lunhuisheng/40W-CCM-Boost-PFC/docs/README.md

# 40 W CCM Boost PFC 工程作品集索引

**2026-10-27 当前 RevB：**RevB 已由项目本人完成主要功能模块器件摆放与全板手工布线，并建立 PGND/AGND 底层分区覆铜。覆铜静态专项终审为 CONDITIONAL GO：可进入最终丝印整理与新版 Gerber/Excellon 本地 CAM 审查，尚未批准直接下单。 83 封装、557 走线、81 过孔、2 zone、0 未连接，KiCad DRC 0 Error、34 Warning；[详细报告](../../hardware/BoostPFC_40W_KiCad/revb_ground_final_review_2026-10-27/REVB_GROUND_POUR_FINAL_REVIEW.md)。本人手工完成 RevB 器件摆放和布线，工具辅助规则审查与文档。尚未下单、焊接或上电。

## 推荐分享顺序

1. [6 页求职快速展示版](output/pdf/40W_BoostPFC_求职快速展示版_最新版.pdf)：HR 或技术初筛。
2. [项目展示总报告](output/pdf/40W_BoostPFC_项目展示总报告_最新版.pdf)：完整概览和证据索引。
3. [项目计划书](output/pdf/40W_BoostPFC_项目计划书_最新版.pdf)、[电源设计](output/pdf/40W_BoostPFC_电源设计与实现报告_最新版.pdf)、[Simulink 验证](output/pdf/40W_BoostPFC_Simulink仿真与验证报告_最新版.pdf)、[PCB 工程](output/pdf/40W_BoostPFC_PCB设计审查与制造资料_最新版.pdf)、[面试手册](output/pdf/40W_BoostPFC_项目总结与技术面试手册_最新版.pdf)。

对应 Markdown：`00_项目展示总报告_最新版.md`、`01`～`05`、`06_求职快速展示版_最新版.md`。[原始证据清单](SOURCE_AUDIT.md)列出哈希与阶段边界。早期 PDF 保留作历史快照，**不得作为当前 RevB 状态**。图 18–30 来自最新 RevB 真实文件；仿真结果始终属于行为模型，不代表实测。

**下一阶段：**处置 DRC 警告、丝印和 `/RECT_IN` 旧悬空过孔，独立复核后生成新版制造文件并本地 CAM；正式下单需人工批准。
