lunhuisheng/40W-CCM-Boost-PFC/ATTRIBUTION.md

# 来源与贡献说明

早期学习与复现参考：[DeepooBelief/BoostPFC](https://github.com/DeepooBelief/BoostPFC)。该公开工程是第三方作品。本公开仓库不复制其原始工程文件，也不把第三方仿真或硬件测试结果称作自己的结果。

本仓库发布的是随后建立的 40 W CCM Boost PFC 自主设计作品：行为级 Simulink 模型与脚本、结构化仿真结果、KiCad 原理图和 RevB PCB、项目展示文档。原理图和 PCB 的器件摆放与 RevB 手工布线由项目作者完成；辅助脚本和工具参与了检查、数据整理和文档生成。

器件型号与数据表归其制造商所有。仓库没有收录第三方数据手册、Infineon 模型下载包、其他 LLC 开源仓库或原始 BoostPFC 仓库代码。
