lunhuisheng/40W-CCM-Boost-PFC/docs/05_项目总结_简历描述与面试手册.md

# 40 W CCM Boost PFC 项目总结、简历描述与面试手册

版本：2026-10-27，RevB 手工布线与覆铜专项终审。基于真实仿真结果、RevB 工程与[终审](../../hardware/BoostPFC_40W_KiCad/revb_ground_final_review_2026-10-27/REVB_GROUND_POUR_FINAL_REVIEW.md)；没有下单、焊接、上电或硬件性能实测。本人实际进行 RevB 器件摆放和全板手工布线；工具辅助建模、静态审查、文档与辅助验证。

## 1. 项目摘要与有证据的工作

本项目把 20–28 Vac/50 Hz 变换为 40 V/40 W，使用整流桥 + CCM Boost 功率级、平均电流模式双闭环、条件式预充旁路和软启动。自主行为级 Simulink 模型从空白模型创建，区别于仓库原开源示例；其 20/24/28 Vac 三点测试在模型内满足稳态误差 ±2%、纹波 ≤2 Vpp、PF ≥0.95、2～40 次 THD ≤10%。24 Vac/40 Ω 两个掉电相位在模型内满足 10 ms 后 ≥34 V。KiCad 项目有 RevA 历史修订、D1 三端错映射修复、独立 PCB 审查和**历史 RevA** 本地 CAM 制造包；RevB 已人工完成主要功能区摆件、557 条走线与 B.Cu PGND/AGND 分区覆铜；当前有 83 封装、81 过孔、2 zone、0 未连接，静态终审 CONDITIONAL GO。上述所有“通过”仅在各自证据层级成立。

最有工程价值的决策：

1. 保留失败启动基线，区分 4.5 A 电流参考上限与实际电流；通过“被动预充→带相位/压差/电流条件旁路→PWM/参考斜坡→稳定后接载”把模型 24 Vac 最终全程峰值记录为 2.835 A（最后的 1.6 s 输入范围测试），而非将早期 6.875 A 隐藏。[证据](../../simulation/simulink/BoostPFC_Design/results/final_input_range/24Vac_metrics.json)。
2. 识别 28 Vac 线峰仅约 1.794 V 模型升压余量和接载峰值 3.968 A，明确这是行为模型边界，不声称器件级已稳健。[证据](../../simulation/simulink/BoostPFC_Design/results/final_input_range/28Vac_metrics.json)。
3. 区分 40 W 恒功率和 40 Ω 恒电阻的掉电理论模型，并在零点/峰值两个相位从**输入实际归零**计时。[证据](../../simulation/simulink/BoostPFC_Design/results/hold_up_test/hold_up_summary.json)。
4. 用数据手册发现旧 PCB 的 D1 两个阳极分别接 VOUT/SW、形成器件内部短路风险；在独立工程中修正符号与封装映射，而不是仅修改 PCB 网络标签。[证据](../../hardware/BoostPFC_40W_KiCad/pcb_revA_2026-10-26_d1fix/D1_FIX_REPORT.md)。
5. 识别理想器件对照约 100.38% 的能量平衡异常，因此不把早期 92.82% 端口功率比值写成已验证效率。[证据](../../simulation/simulink/BoostPFC_Design/results/ideal_component_metrics.json)。

## 2. 可直接使用的简历描述

**项目：40 W CCM Boost PFC 电源设计与仿真｜个人学习项目，工具辅助工程实现** 规划 20–28 Vac/40 V·40 W 指标，建立整流 Boost、双 PI 电流/电压环及条件预充软启动的 Simulink 开关行为模型；完成三输入点、接载与掉电保持验证，记录 PF 0.9956–0.9971、2～40 次 THD 5.37%–6.29%、输出纹波 1.49–1.52 Vpp（均为**仿真**）；参与 KiCad 原理图与 RevA PCB 审查，发现并修正 D1 封装极性错映射，完成历史 RevA Gerber/钻孔本地 CAM 核验；本人完成 RevB 主功率、Gate、Kelvin/OCP、锁存、MCU 去耦与辅助供电模块器件摆放和全板手工布线，并配置 Net Class/线宽/间距，完成 PGND/AGND 分区覆铜静态终审；当前进行丝印与制造前审查，尚未下单或进行硬件性能实测。

若招聘方对个人贡献追问，可补充：本人负责设定规格、理解并审阅拓扑/控制/关键引脚及结果，使用 Codex、KiCad CLI 和 MATLAB 脚本辅助建模、检查、记录；不宣称所有模型与审查脚本均由本人手工独立敲写；RevB PCB 器件摆放与布线由本人手工完成。

## 3. 三分钟项目介绍稿

“我做的是一套 40 W、40 V 输出的低压交流输入 Boost PFC 学习项目，输入范围 20 到 28 Vac，额定 24 Vac，开关频率 50 kHz。这个项目的目标是完整走过规格、参数、控制、仿真、原理图和 PCB 审查流程，目前还没有制作或测试实物。

功率级由整流桥、470 微亨电感、MOSFET、Boost 二极管和 2200 微法输出电容构成。控制上用电压外环决定输入电流幅值，电流内环让电感电流参考跟随整流输入电压，再用 PWM 调制。启动阶段发现仅靠固定延时，预充旁路后电感电流仍会冲高；我保留了各失败版本，改成电压、输入相位相关的压差与电流共同合格后旁路，再做 100 毫秒参考斜坡，输出稳定才接 40 欧负载。

最终行为模型在 20、24、28 Vac 三点的输出平均值都接近 40 V，纹波约 1.49 到 1.52 Vpp，PF 约 0.996，2 到 40 次谐波算出的 THD 约 5.37% 到 6.29%。24 Vac 的 10 毫秒掉电保持在过零和峰值两个相位都达到 34 V 以上。不过 28 Vac 线峰的升压余量很小，而且这些全是软件模型结果。

硬件侧，我重点核对了四端分流器 Kelvin 连接、AGND/PGND 的单点连接、比较器直接关断与硬件故障锁存，还在 PCB 交叉审查中发现 D1 三端封装的阳极/阴极网络错接，修复后才进入历史 RevA 制造文件的本地 CAM 检查。目前我在 RevB 上完成主要功能区人工摆件和全板手工布线，专项补齐 STM32G431 多电源去耦，地铜经静态终审有条件通过。下一步是解决丝印和残余警告，再做新版制造文件的本地 CAM 审查。现在没有下单或硬件测试，因此我不会把仿真 PF、效率或保护阈值称为实测。”

## 4. 高频技术问答（12 题）

1. **为什么选 Boost PFC？** 输入电感便于塑造整流电流，输出可高于整流电压；但在 28 Vac 线峰接近 40 V 时，最小占空比和器件压降会限制调节能力，需单独核查。[设计报告](02_电源设计与实现报告.md)
2. **CCM 是不是全工频周期成立？** 不是。电流在主要传功区按连续模式设计，过零附近可能到零；行为模型不能证明所有工况严格 CCM。[设计记录](../../simulation/simulink/BoostPFC_Design/DESIGN_NOTES.md)
3. **为什么电流参考与整流电压成比例？** 电压环输出给出幅值，`iL,ref=A_v·vrect/Vrect,pk`，使交流输入电流包络近似同相正弦；若限幅、延迟或线峰余量不足，仍会有 THD。[初始化脚本](../../simulation/simulink/BoostPFC_Design/BoostPFC_Design_Init.m)
4. **为什么电压环慢于电流环？** 电流环约 3.04 kHz，电压环约 5.86–8.75 Hz 的连续平均分析具有带宽层级；慢电压环避免追逐 100 Hz 功率脉动。实际采样/PWM 延迟未确认。[环路 JSON](../../simulation/simulink/BoostPFC_Design/results/loop_audit/loop_audit_summary.json)
5. **470 µH 怎么确定？** 是项目初值，通过开关纹波和电流峰值行为仿真做了筛查；尚未完成磁芯损耗/温升/容差下的最优选型，不能说已全方面验证。[功率热审查](../../hardware/BoostPFC_40W_KiCad/prepcb_risk_review_2026-10-26/POWER_THERMAL_REVIEW.md)
6. **2200 µF 的依据？** 恒功率 40→34 V/10 ms 理论至少 1801.8 µF，100 Hz/2 Vpp 近似至少 1591.5 µF；模型零点/峰值掉电 10 ms 后为 35.568/35.704 V。实际电容容差、ESR、寿命仍待验证。[掉电 JSON](../../simulation/simulink/BoostPFC_Design/results/hold_up_test/hold_up_summary.json)
7. **4.5 A 算硬件限流吗？** 不算。一个 4.5 A 是模型的电流幅值参考上限，另一个是模型故障阈值；实际周期抑制设 4.0 A。硬件 R2/INA180/TLV3201/驱动器链只有静态与网络审查，动态峰值和关断延迟尚未实测。[风险审查](../../hardware/BoostPFC_40W_KiCad/prepcb_risk_review_2026-10-26/PREPCB_RISK_REVIEW.md)
8. **PWM 关了，为什么还会有浪涌？** 整流输入仍能经 L1 和 D1 被动充 C1，PWM 抑制不能控制这条通路；所以先设预充电阻、旁路时检查压差和电感电流。[启动记录](../../simulation/simulink/BoostPFC_Design/DESIGN_NOTES.md)
9. **四端分流器的 Kelvin 意义？** 功率端串接回流，两个采样端独立引到 INA180，避免大电流焊盘/走线压降混入 10 mΩ 测量；主回流不能绕过 R2。[PCB 审查](../../hardware/BoostPFC_40W_KiCad/independent_final_review_opus_2026-10-26/INDEPENDENT_FINAL_REVIEW_OPUS.md)
10. **D1 修过什么致命错误？** 该三端器件 1/2 为内部相连阳极、3 为阴极。旧 PCB 将 1 接 VOUT、2 接 SW，装件后可能短接两网；修订三端符号让 1/2=SW、3=VOUT，再从原理图正常同步 PCB。[修复报告](../../hardware/BoostPFC_40W_KiCad/pcb_revA_2026-10-26_d1fix/D1_FIX_REPORT.md)
11. **DRC=0、CAM 通过为何还不能说电源可用？** DRC 查规则，CAM 查制造数据的静态一致性，不覆盖器件内部引脚、热、瞬态保护和真实上电。该项目旧 DRC=0 仍被发现 D1 错映射。[阶段 PCB 报告](04_PCB设计审查与制造资料_阶段版.md)
12. **效率多少？** 尚无可信效率结论。早期非理想模型的端口比约 92.82%，但理想对照出现 100.38%，提示数值能量平衡问题；不能写成 92.82% 已验证，更没有实物效率。[原 JSON](../../simulation/simulink/BoostPFC_Design/results/ideal_component_metrics.json)

## 5. 可能的质疑与诚实回答

| 质疑 | 有证据的回答 |
|---|---|
| “这是开源项目改名吗？” | 根仓库确有开源工程；自主 `BoostPFC_Design` 模型另由建模脚本从空白建立。要展示脚本与独立结果，并明确学习来源。 |
| “40 W 为何连实物都没上电？” | 当前目标是设计与仿真作品，完成静态 KiCad/CAM；没有实验室条件，故所有物理性能保持未验证，裸板也尚未下单。 |
| “28 Vac 结果通过就没有风险？” | 模型稳态指标通过，但线峰升压余量约 1.794 V，接载峰值逼近行为级 4 A 设定；器件压降、死区、寄生和温度可能改变结论。 |
| “为什么接载会跌到 33.66 V？” | 20 Vac 最终行为测试确有该最低值，且没有正式负载瞬态下限；不能拿另一个掉电 34 V 指标判负载动态失败或成功。 |
| “为什么 PCB 报告哈希不匹配？” | 历史制造 ZIP 未变，但当前 d1fix/RevB 文件后来发生保存或编辑，原因未审定；重新制造必须用新哈希重做完整版本和 CAM 核查。 |

最终可用于展示的边界句：**“已完成自主 40 W Boost PFC 行为模型、参数与控制分析、KiCad 原理图及历史 RevA PCB/本地 CAM 审查；RevB 主要模块人工摆件与规则配置已进行；最终走线、覆铜、裸板打样及实物电气验证尚未完成。”**

## 6. 2026-10-27 求职状态更新

RevB 已由项目本人完成主要功能模块器件摆放与全板手工布线，并建立 PGND/AGND 底层分区覆铜。覆铜静态专项终审为 CONDITIONAL GO：可进入最终丝印整理与新版 Gerber/Excellon 本地 CAM 审查，尚未批准直接下单。 当前 PCB SHA-256 `2BB23CBACD7A38E5F8491438F23DFACB0250224D6A2BCA3105C27D4691244414`，83 封装、557 走线、81 过孔、2 zone，0 未连接。由本人手工布局和布线，工具辅助 KiCad 规则检查、几何审查与文档整理。可在面试中展示 [当前全板图](figures/18_RevB_current_full_routed.png)、[Kelvin 局部](figures/21_RevB_Kelvin_U3.png)、[地铜终审](../../hardware/BoostPFC_40W_KiCad/revb_ground_final_review_2026-10-27/REVB_GROUND_POUR_FINAL_REVIEW.md)和行为模型结果。不可说“已下单/已打板”或把 PF、THD、效率写成硬件实测。

若被问 DRC 0 Error 是否等于能上电：回答“不是。还有 34 条警告、机械和热设计审查、制造文件 CAM、厂家审核；动态过流、温升、EMI、效率和 PF/THD 都没有硬件实测。”
