lunhuisheng/40W-CCM-Boost-PFC/docs/06_求职快速展示版_最新版.md

# 40 W CCM Boost PFC 求职快速展示版｜6 页

## 第 1 页｜项目
20–28 Vac / 50 Hz → 40 V / 1 A / 40 W，50 kHz，CCM Boost PFC。自主行为级仿真、KiCad 原理图及保护链、RevB 人工器件摆放与手工布线。

## 第 2 页｜行为模型结果
20/24/28 Vac 的 Vout 平均 39.9829/39.9910/39.9920 V；PF 0.99714/0.99652/0.99558；THD 5.3722/5.4714/6.2925%（2–40 次）；纹波 1.5213/1.5035/1.4910 Vpp。24 Vac 掉电 10 ms 后输出 35.5683 V（近过零）/35.7036 V（近峰值）。**Simulation result：非实物数据。**

## 第 3 页｜硬件架构
整流/预充 → L1/Q1/D1/C1 Boost → 输出；R2 四端 Kelvin → INA180A2 → TLV3201 → 独立硬件锁存/驱动关断；STM32G431 双环控制与 C40–C48 电源去耦。

## 第 4 页｜当前 RevB PCB
83 封装、557 走线、81 过孔、2 个 B.Cu 分区地 zone、0 未连接。本人完成布局和布线；工具辅助静态审查。NT1 静态单点连接 PASS；覆铜审查 CONDITIONAL GO。

## 第 5 页｜工程问题
启动冲击、28 Vac 升压余量、D1 三端错映射、Kelvin 采样、PGND/AGND 单点地、STM32G431 多供电脚去耦与功率/Gate/模拟网络类配置。每项均保留设计边界和未实测风险。

## 第 6 页｜当前状态
RevB 手工布局布线与分区覆铜静态审查完成。**Silkscreen → DRC → Gerber/Excellon → CAM → 厂家审核 → 人工批准裸板下单**。目标 2026-10-28 继续制造前收敛；尚未下单或进行任何实物电气验证。
