lunhuisheng/40W-CCM-Boost-PFC/hardware/latest/BoostPFC_40W_模块导线学习图册.pdf

# 01 交流输入、整流与预充

# 先沿 J1 → BR1 → R1 → RECT_IN 阅读；K1 的触点旁路 R1。下方 R41、Q2、R51、D41 是继电器线圈驱动，长导线将线圈回路接回 K1。

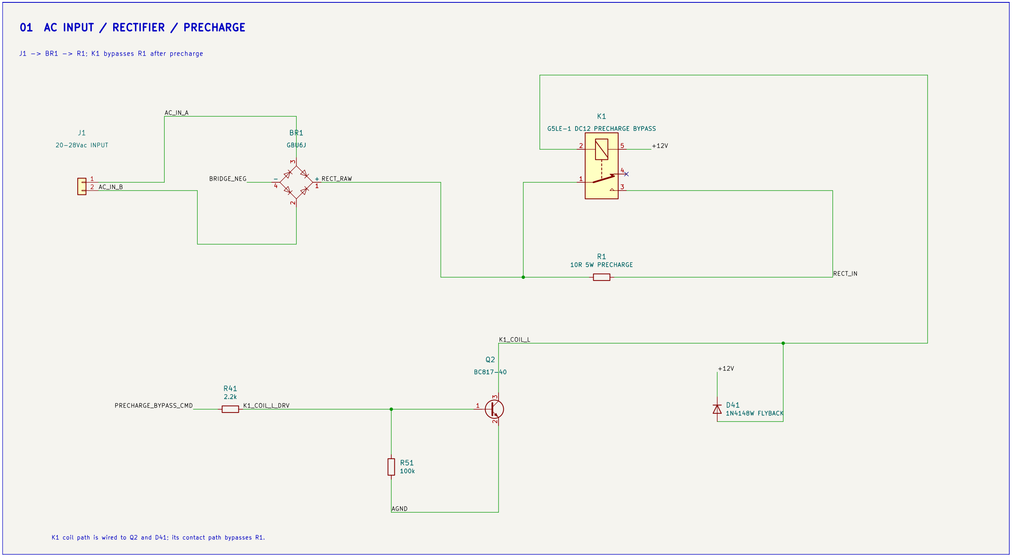
[picture p22: figure]
R1 10R 5W PRECHARGE; G5LE-1 DC12 PRECHARGE BYPASS; 1N4148W FLYBACK R51; GBU6J; 20-28Vac INPUT; AGND; RECT_IN +12V; BRIDGE_NEG; RECT_RAW; 01 AC INPUT / RECTIFIER / PRECHARGE; 10R 5W PRECHARGE; GBU6J +

K1_COIL_L PRECHARGE_BYPASS_CMD | K1_COIL_L_DRV

# J1 -> BR1 -> R1; K1 bypasses R1 after precharge

K1 coil path is wired to Q2 and D41; its contact path bypasses R1.

# 学习整理版：电气连接保持 RevB 基线；模块之间同名网络相连。

# 02 Boost 主功率级

沿 RECT_IN → L1 → SW → D1 → C1/J2 阅读。Q1 从 SW 接到 PGND；R2 功率端串在 PGND 与 BRIDGE_NEG 之间，两个 Kelvin

# 端单独引到模块 04。

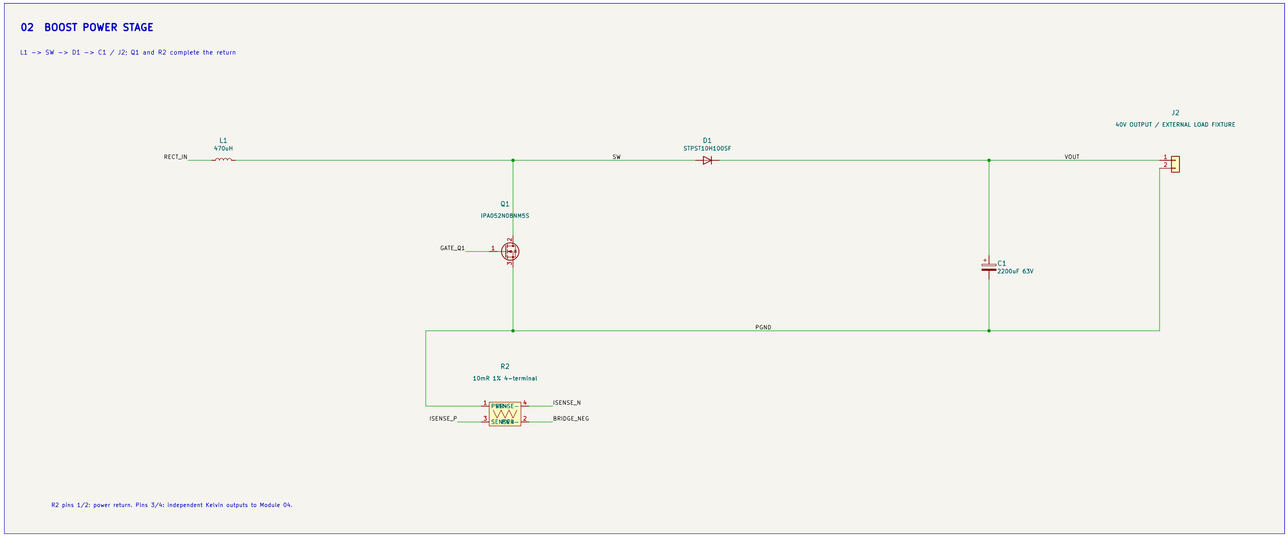
[picture p23: figure]
D1 STPST10H100SF 1; IPA052N08NM5S; PWR+; PWR-; SENSE+; SENSE-; 10mR 1% 4-terminal; 40V OUTPUT / EXTERNAL LOAD FIXTURE C1; VOUT; GATE_Q1; ISENSE_P; BRIDGE_NEG; ISENSE_N; PGND; RECT_IN; 10R 5W PRECHARGE; 10mR 1% 4-terminal PWR+; 2 3 D1 STPST10H100SF; 40V OUTPUT / EXTERNAL LOAD FIXTURE 1

## L1 -> SW -> D1 -> C1 / J2; Q1 and R2 complete the return 02 BOOST POWER STAGE

R2 pins 1/2: power return. Pins 3/4: independent Kelvin outputs to Module 04.

# 03 MOSFET 栅极驱动

沿 PWM_CMD → R30 → U2 → R31 → GATE_Q1 阅读。R33 是 PWM 下拉，R32/D3 接在 Gate 与 PGND 之间；DRIVER_DISABLE

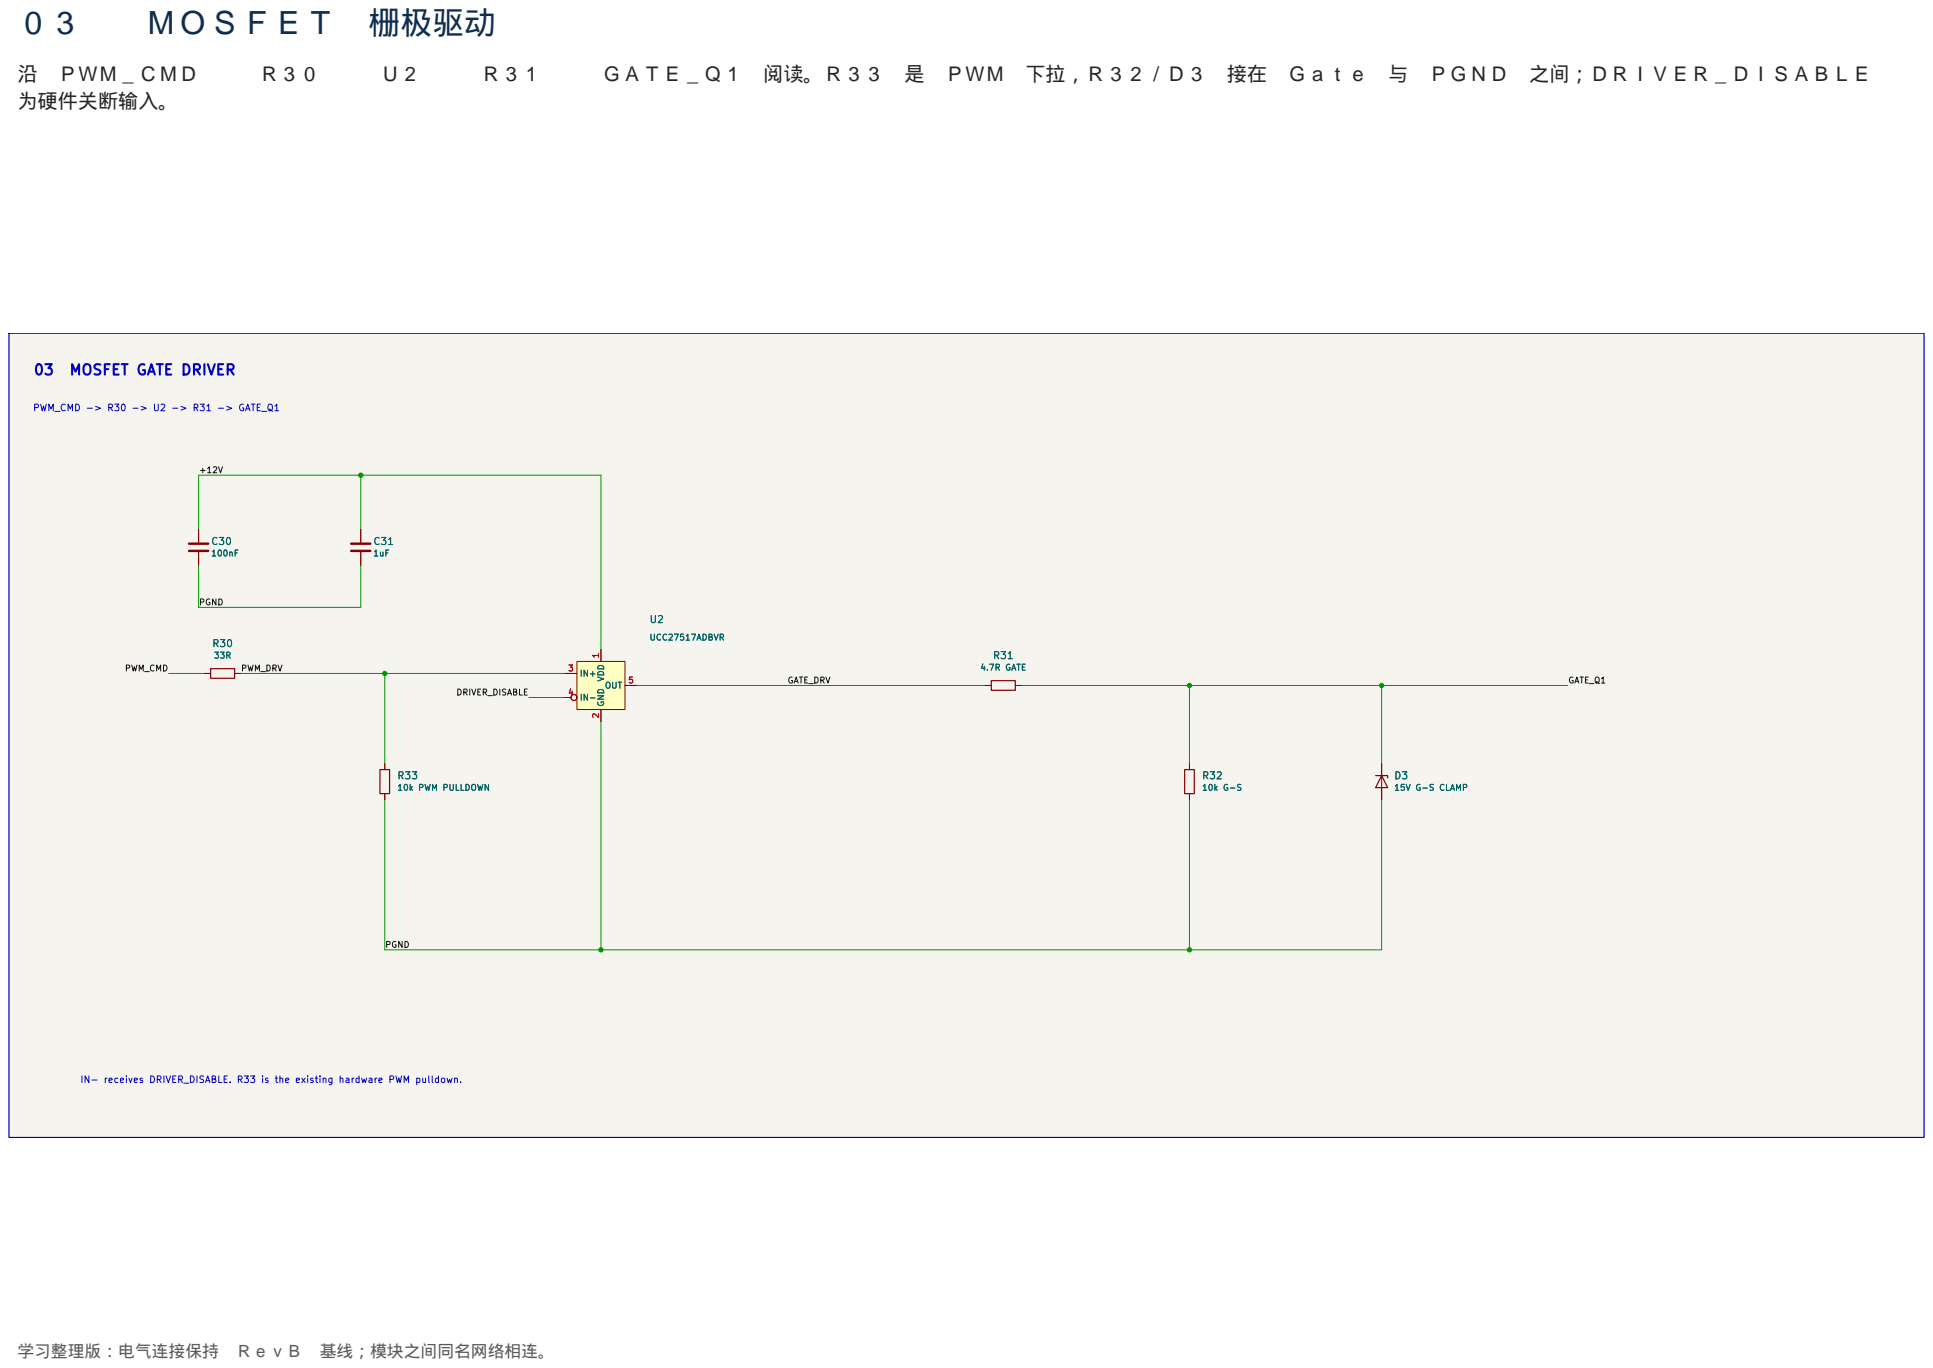
[picture p24: page 3]

IN- receives DRIVER_DISABLE. R33 is the existing hardware PWM pulldown.

# 04 Kelvin 电流采样

# ISENSE_P/N 分别经 R20/R21 接至 U3 两个输入；C20 跨接 INA_P 与 INA_N。U3 的输出 ISENSE_ADC 同时送给 MCU 和硬件比较器。

1 GND 2 +

3 -
4 V+

5 U3

# INA180A2IDBVR

C24

# 100nF U3 LOCAL

C20
1nF

R20
10R R21

10R

# AGND

# ISENSE_N

# ISENSE_P

# INA_P

# INA_N

# ISENSE_ADC +3V3

# AGND

# 04 KELVIN CURRENT SENSE

# R2 sense terminals -> R20 / R21 -> U3 -> ISENSE_ADC

C20 is between INA_P and INA_N, not an input-to-ground capacitor.

C20

1nF | C24

# 100nF U3 LOCAL U3

# INA180A2IDBVR

1 GND 2 +

3 -
4 V+

5

R20
10R R21

10R

# 05 输出与整流输入电压采样

# 左侧 R10/R11/R12 与 C10 测 VOUT；右侧 R13/R14/R15 与 C11 测 RECT_RAW。先看分压链，再看 ADC 节点和地回路。

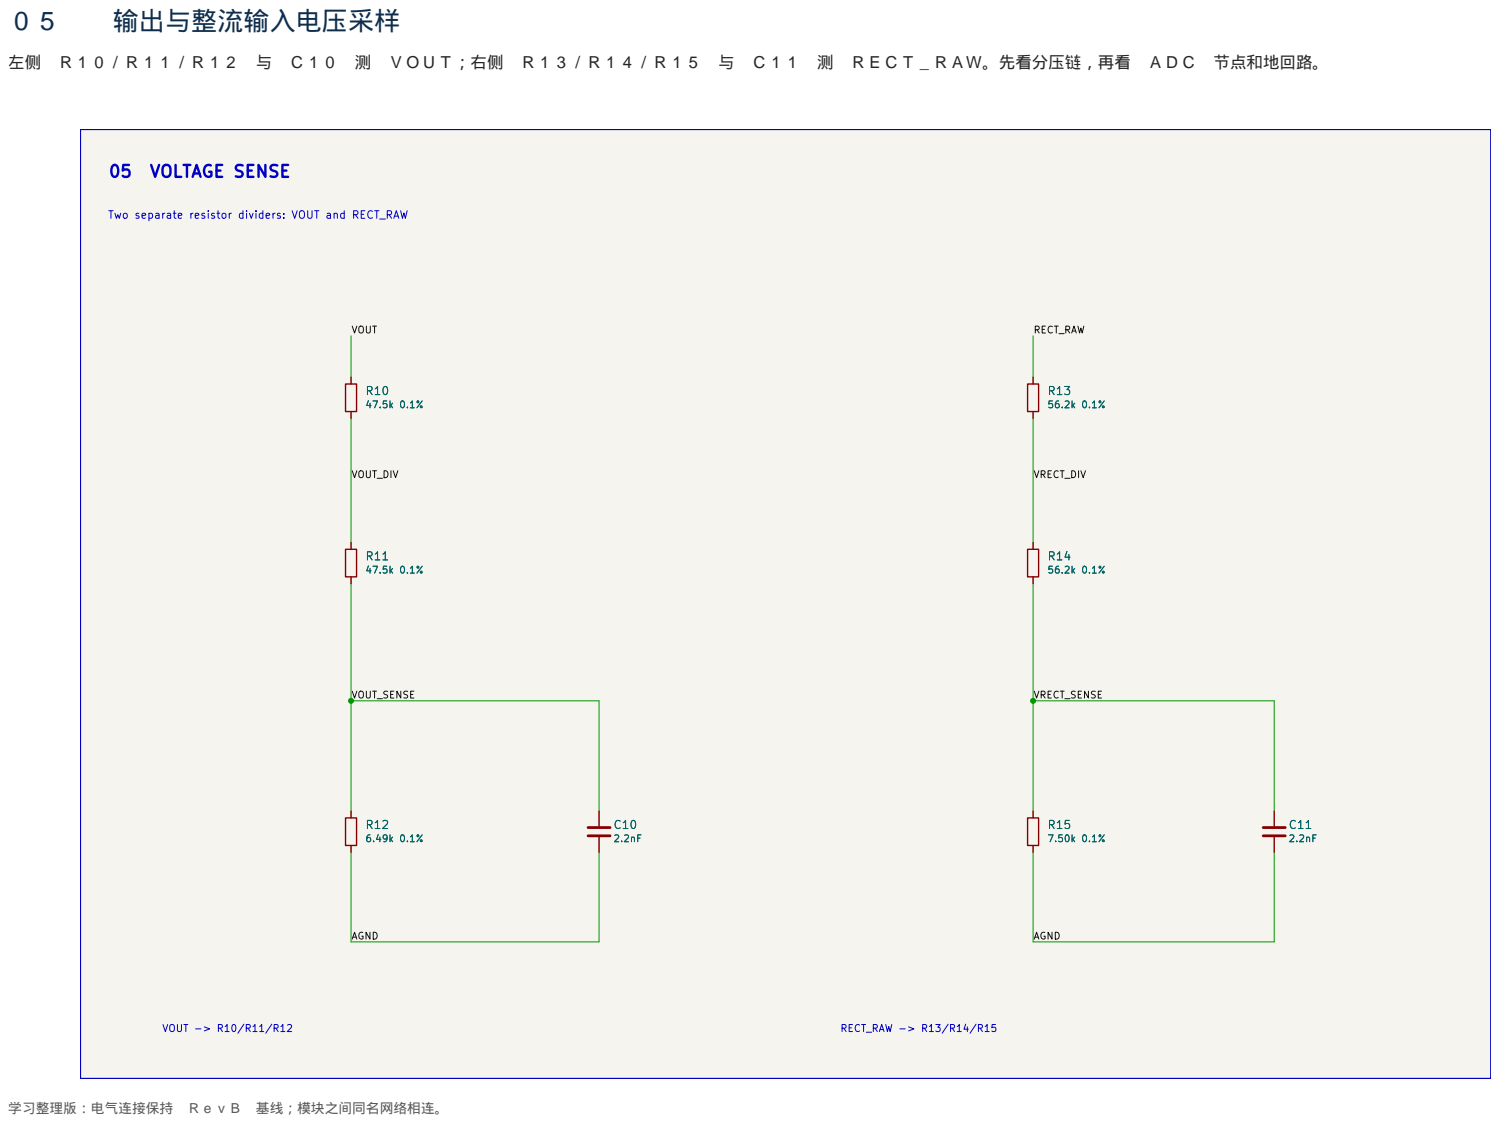
[picture p25: page 5]

Two separate resistor dividers: VOUT and RECT_RAW

# 06 硬件过流比较器

# R23/R24 生成 OCP_REF，C23 对参考节点去耦；U4 比较 ISENSE_ADC 与 OCP_REF，输出 OC_RAW。此页仅展示原有连接，不新增保护精度结论。

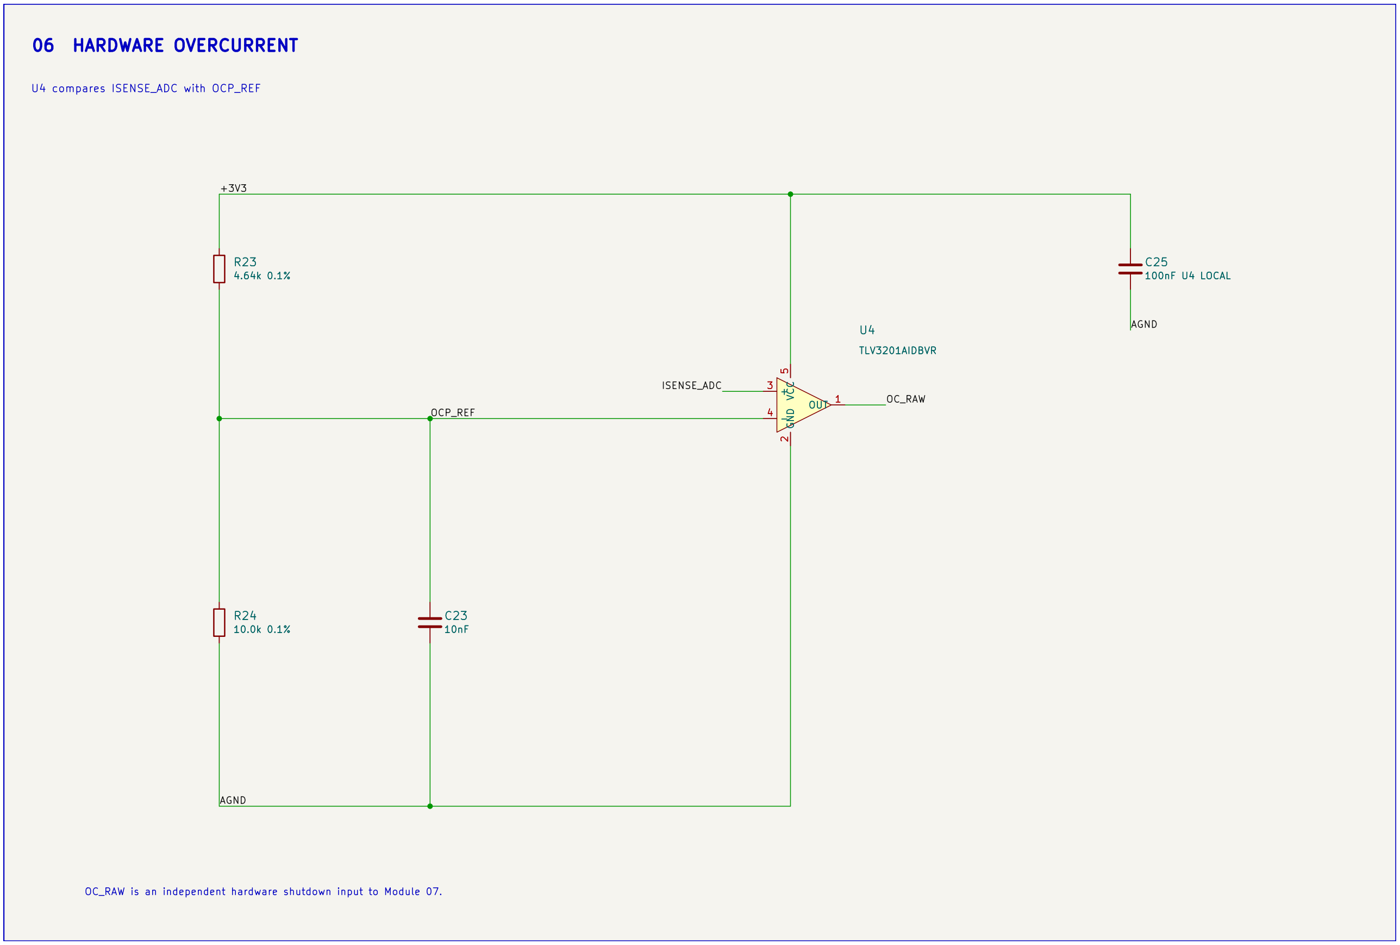
[picture p26: figure]
C25 100nF U4 LOCAL R24; OUT 1 GND; 3 - 4 VCC; TLV3201AIDBVR C23; AGND; ISENSE_ADC; OC_RAW; U4 compares ISENSE_ADC with OCP_REF; 06 HARDWARE OVERCURRENT; 100nF U4 LOCAL R23 4.64k 0.1% R24; TLV3201AIDBVR OUT 1 GND

VRECT_DIV | OCP_REF +3V3

OC_RAW is an independent hardware shutdown input to Module 07.

# 07 故障锁存、上电复位与人工复位

# 上方 U8 → U6 的 PRE 路径体现 POR；U6 的 Q 输出进入 U7。下方 SW1 → C65/R63/R62/D65 → U10 → U9 → U6 CLR

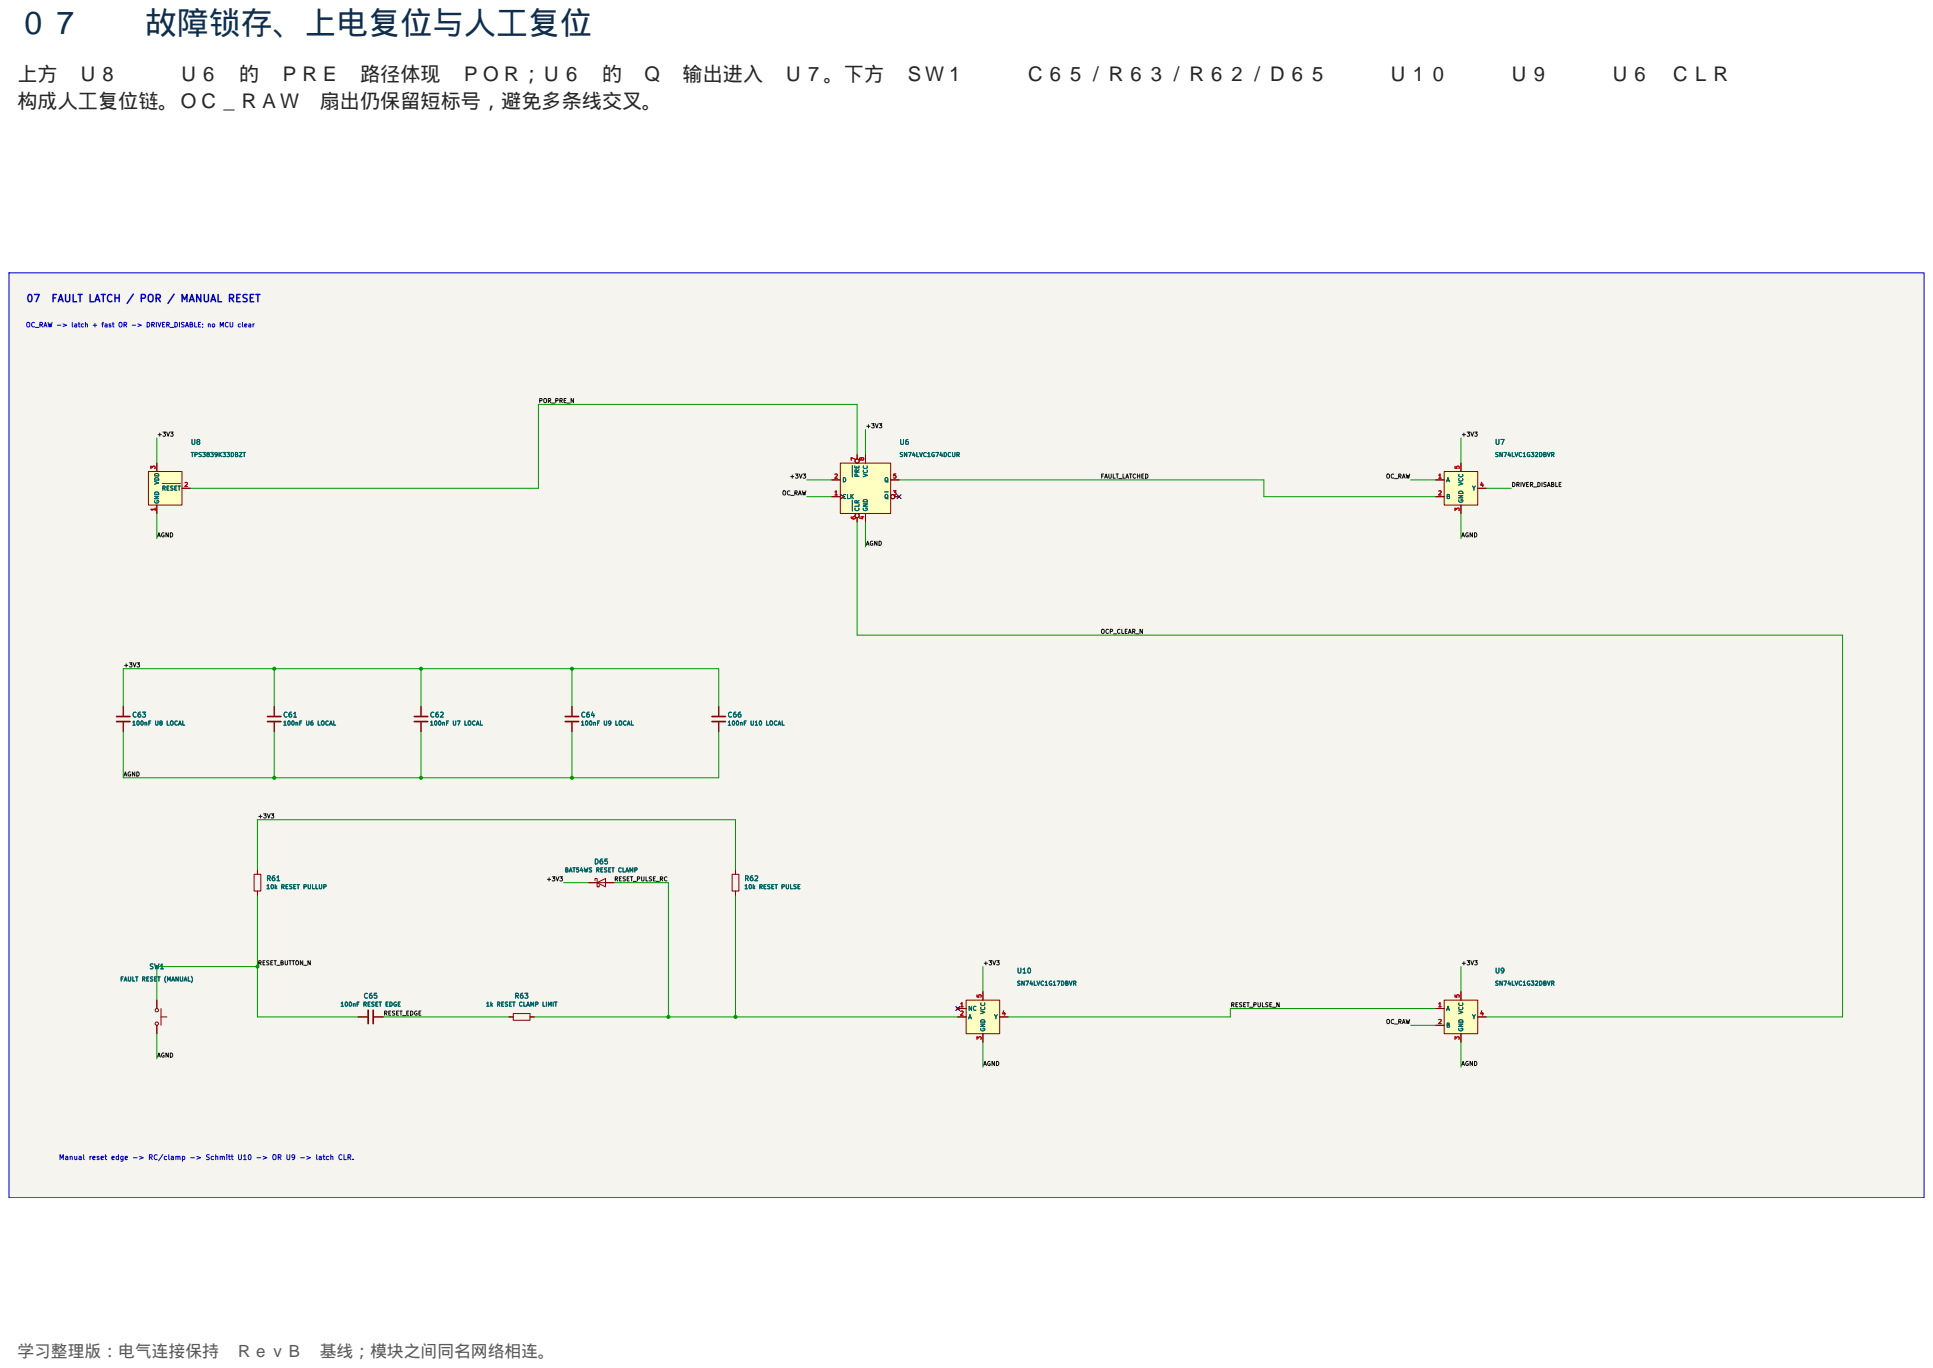
[picture p27: page 7]

07 FAULT LATCH / POR / MANUAL RESET

OC_RAW -> latch + fast OR -> DRIVER_DISABLE; no MCU clear

Manual reset edge -> RC/clamp -> Schmitt U10 -> OR U9 -> latch CLR.

# 08 STM32 控制接口与电源去耦

先看 U1 的供电、模拟采样、PWM、故障状态和 SWD 接口，再读 C40–C48。图上的去耦电容排成学习用电源母线，不代表 PCB 上应集中摆放；PCB 应各自靠近对应电源脚。

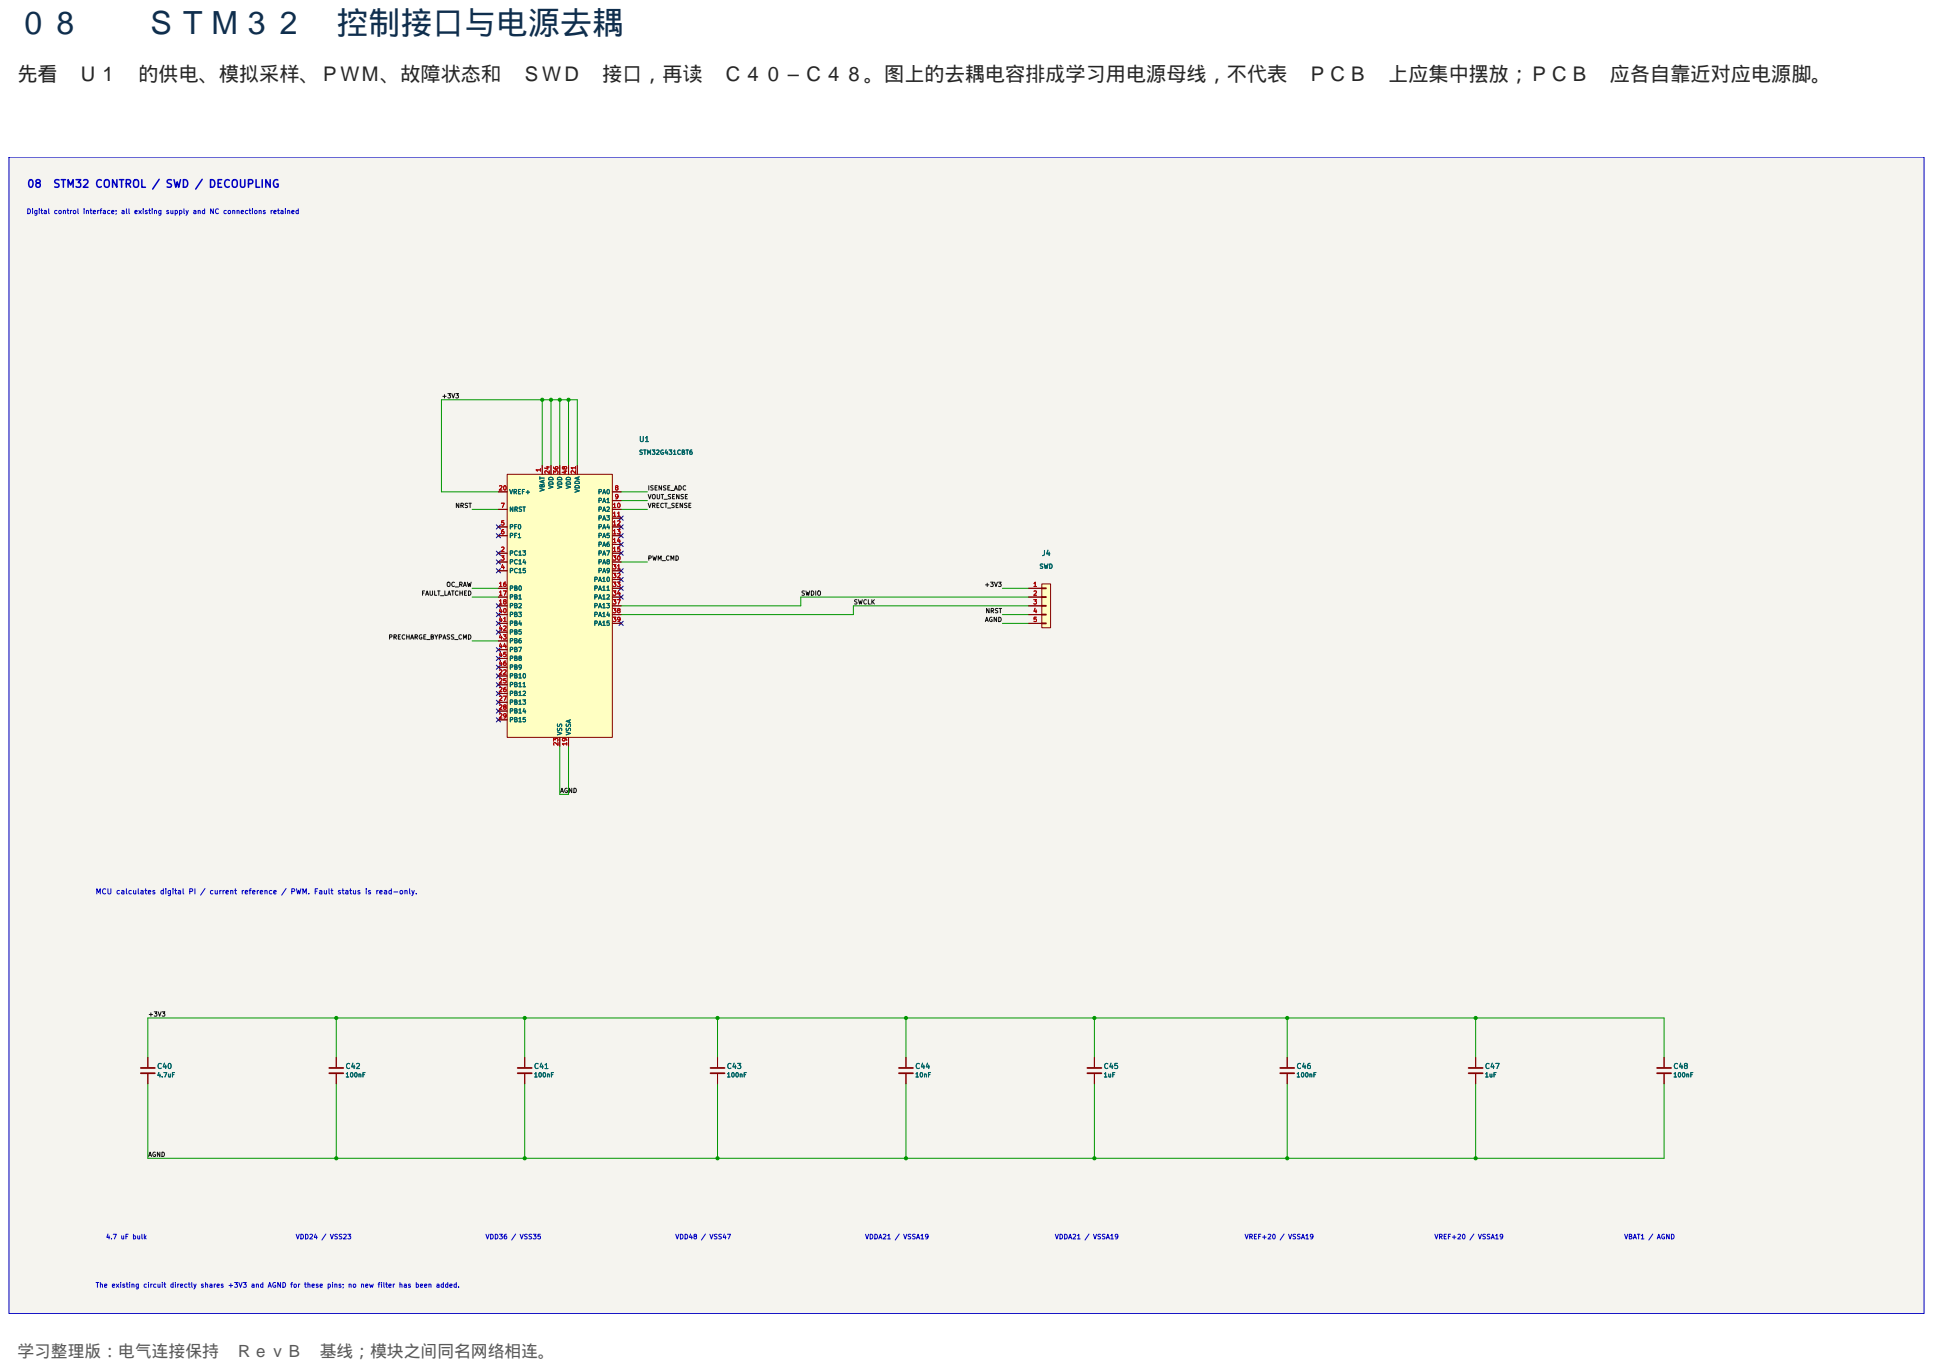
[picture p28: page 8]

Digital control interface; all existing supply and NC connections retained

# 09 12 V 辅助电源与 3.3 V 稳压

# 沿 J3 → U5 → +3V3 阅读。U5 的 IN/EN 均接现有 +12V；C50/C51 分别位于输入与输出，返回 AGND。

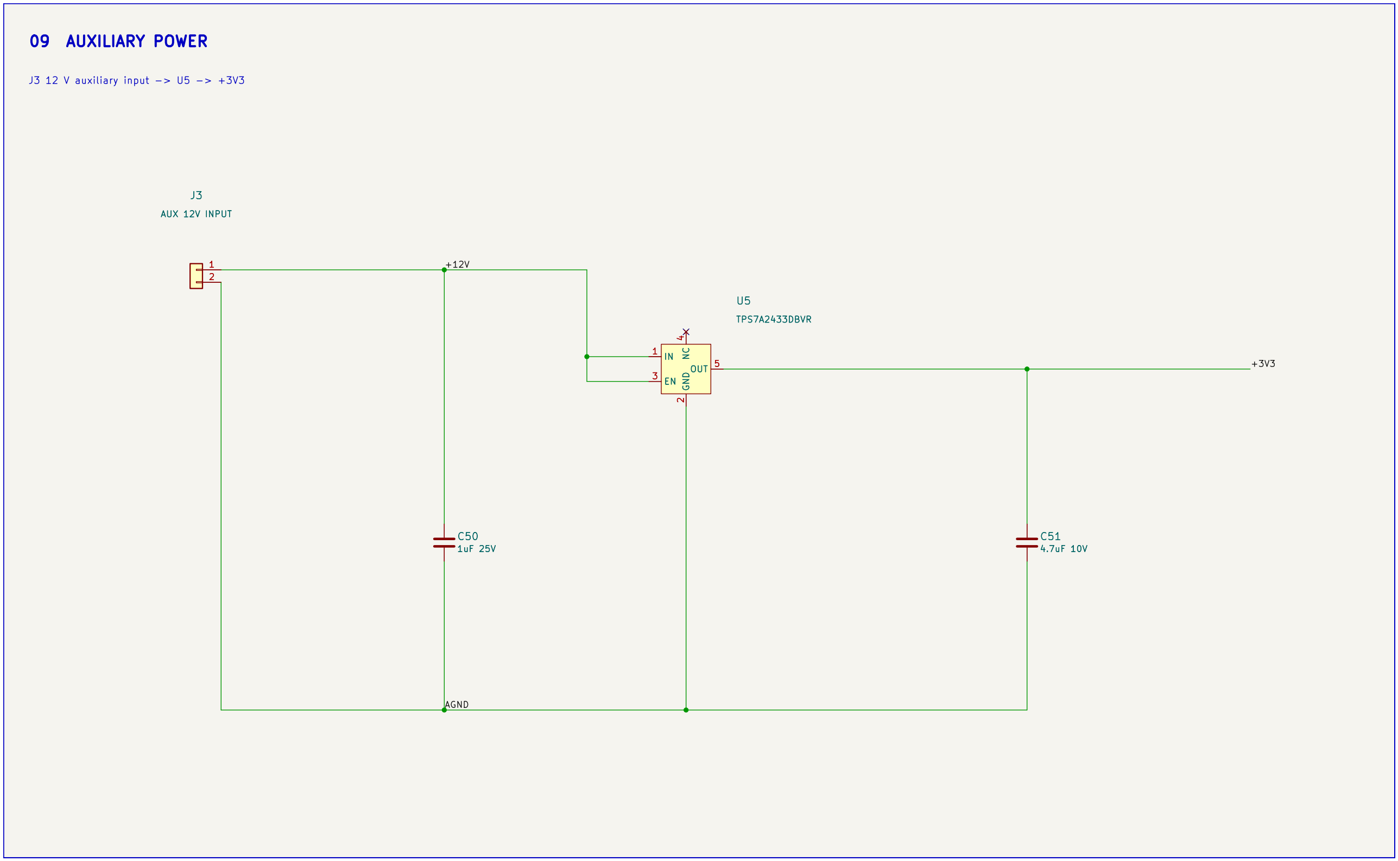
[picture p29: figure]
AUX 12V INPUT; GND; 4 OUT 5 U5; TPS7A2433DBVR; AGND; J3 12 V auxiliary input -> U5 -> +3V3; 09 AUXILIARY POWER; AUX 12V INPUT 1; 4 OUT 5

# 10 地单点连接与测试点

# NT1 的两端仍分别为 PGND 与 AGND。TP1–TP7 通过相同网络名对应前面各模块的测量节点；它们是观测接口，不是信号链中的串联元件。

O

P

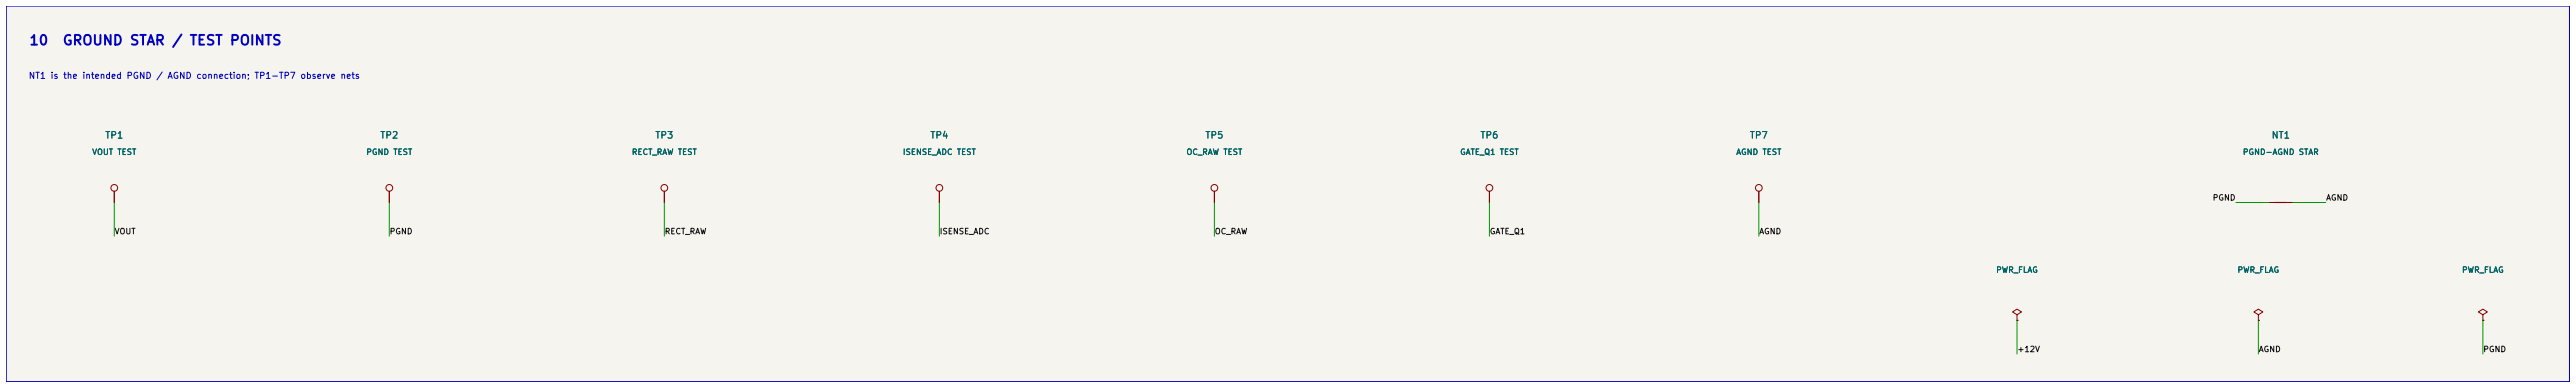
[picture p30: figure]
TP4 ISENSE_ADC TEST TP1; VOUT TEST; PGND TEST; OC_RAW TEST; PWR_FLAG; RECT_RAW TEST; AGND TEST TP6; GATE_Q1 TEST; PWR_FLAG NT1; PGND-AGND STAR; VOUT; PGND; ISENSE_ADC; OC_RAW; AGND; RECT_RAW; GATE_Q1; 10 GROUND STAR / TEST POINTS; ISENSE_ADC TEST

NT1 is the intended PGND / AGND connection; TP1-TP7 observe nets
