lunhuisheng/40W-CCM-Boost-PFC/docs/figures/29_RevB_current_schematic.png

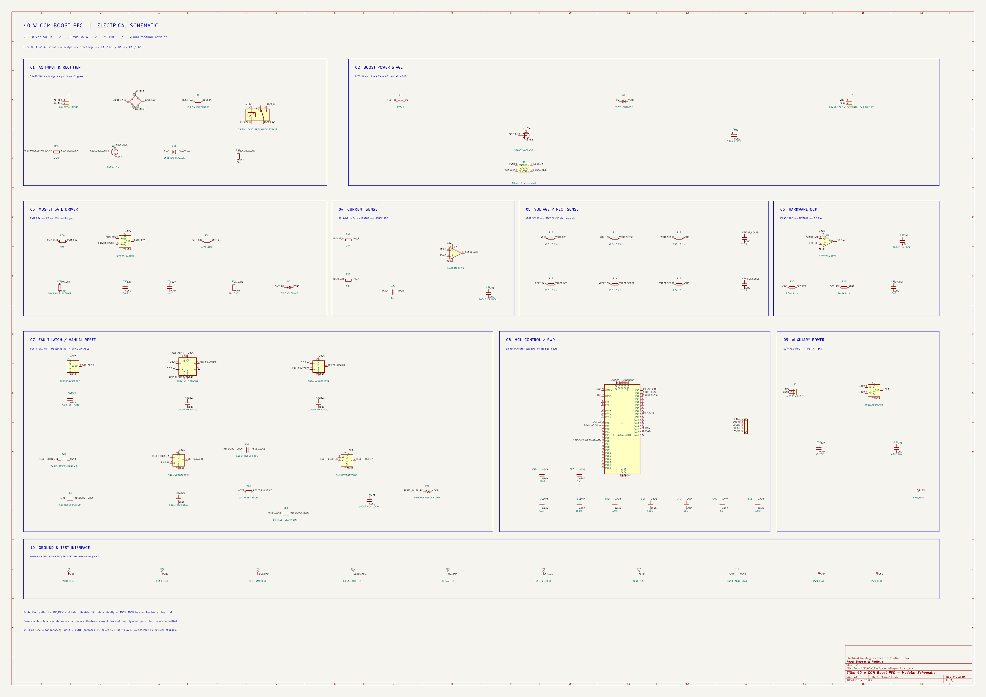
docs/figures/29_RevB_current_schematic.png
