lunhuisheng/40W-CCM-Boost-PFC/hardware/learning/previews/Module_02.png

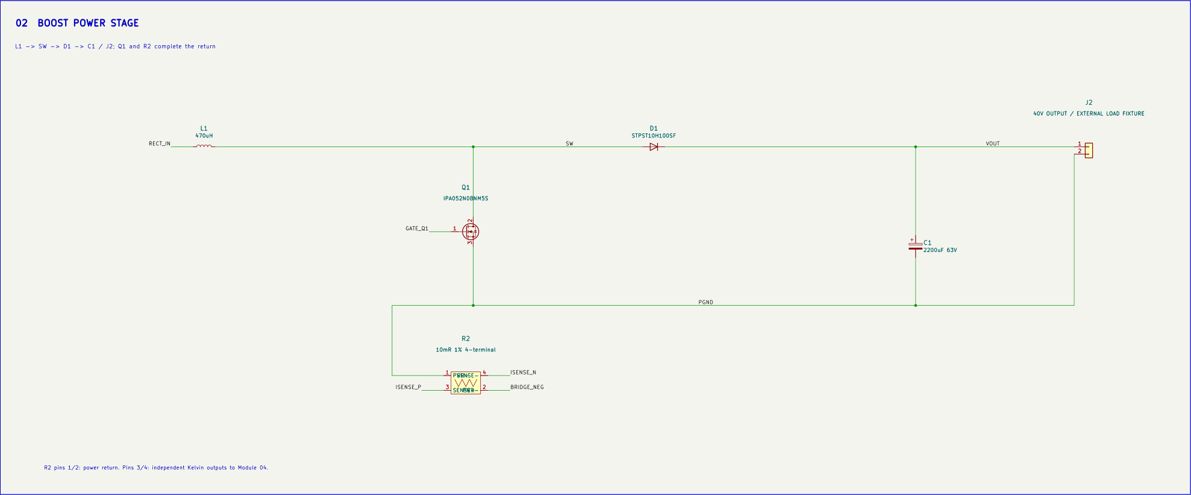
hardware/learning/previews/Module_02.png
