lunhuisheng/40W-CCM-Boost-PFC/hardware/learning/previews/Module_03.png

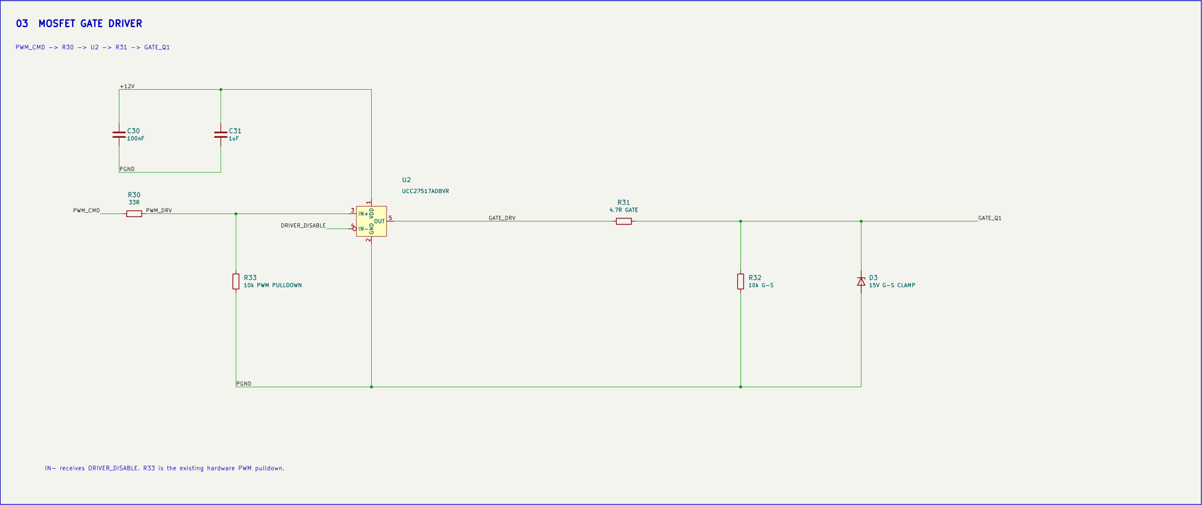
hardware/learning/previews/Module_03.png
