lunhuisheng/40W-CCM-Boost-PFC/hardware/learning/previews/Module_04.png

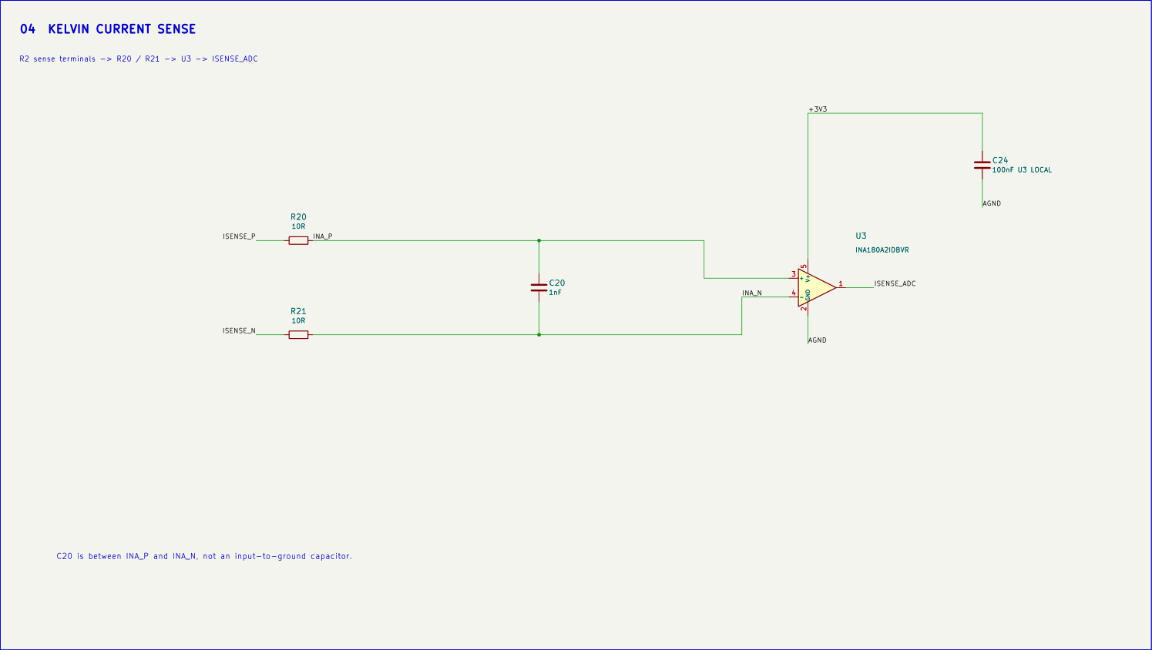
hardware/learning/previews/Module_04.png
