lunhuisheng/40W-CCM-Boost-PFC/hardware/learning/previews/Module_05.png

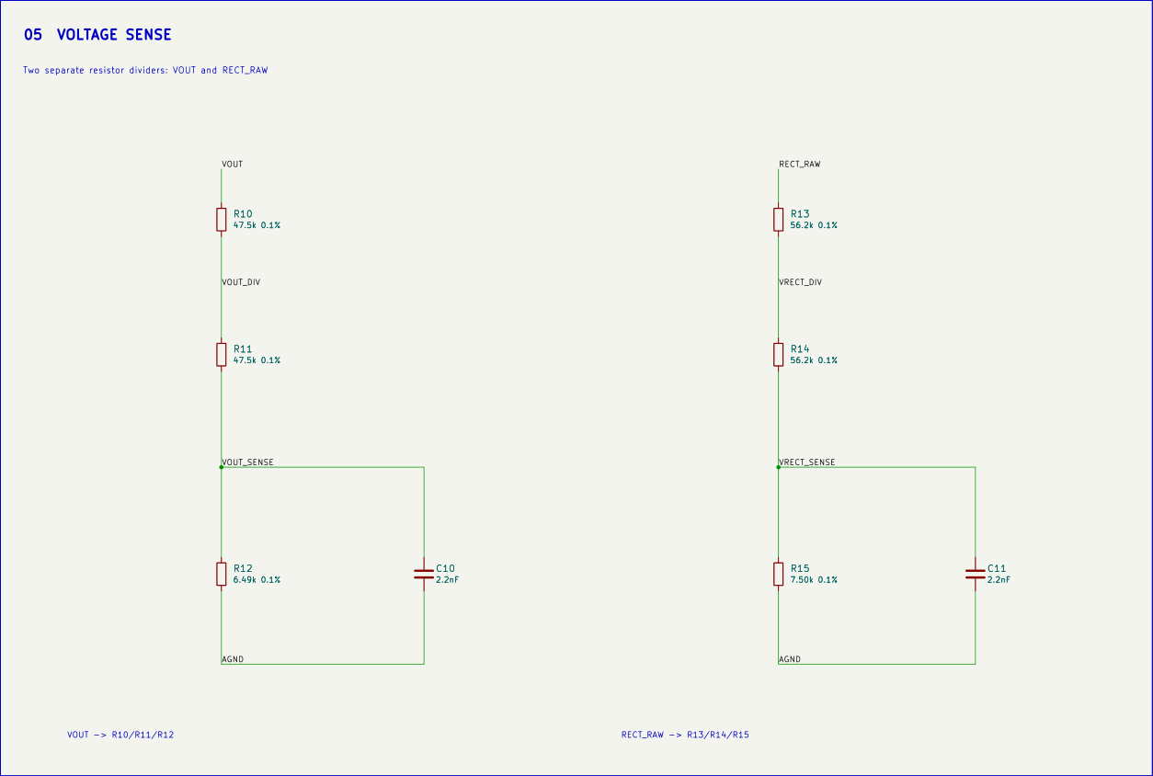
hardware/learning/previews/Module_05.png
