lunhuisheng/40W-CCM-Boost-PFC/hardware/learning/previews/Module_07.png

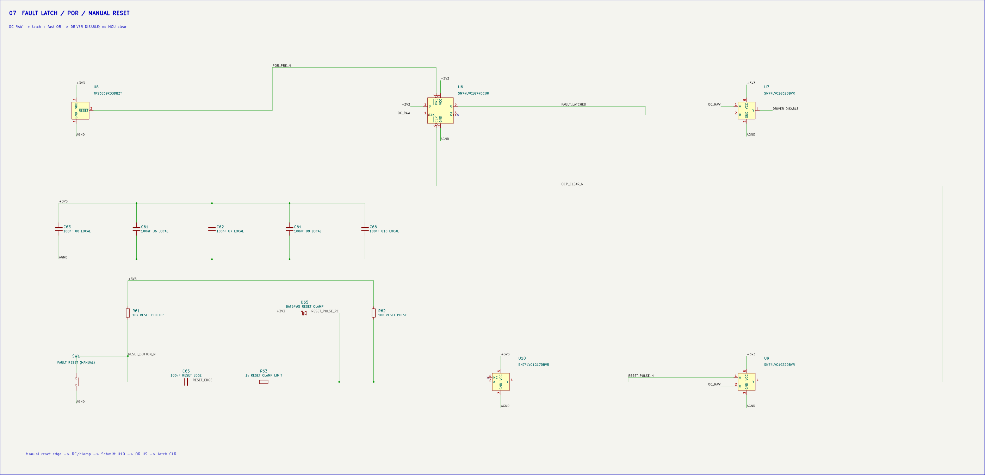
hardware/learning/previews/Module_07.png
