lunhuisheng/40W-CCM-Boost-PFC/hardware/learning/previews/Module_08.png

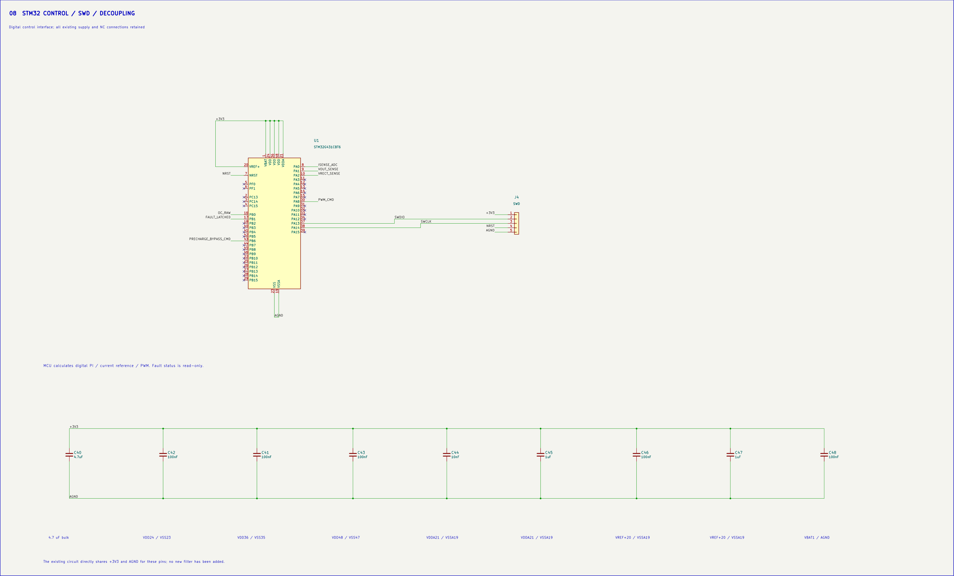
hardware/learning/previews/Module_08.png
