lunhuisheng/40W-CCM-Boost-PFC/hardware/learning/previews/Module_09.png

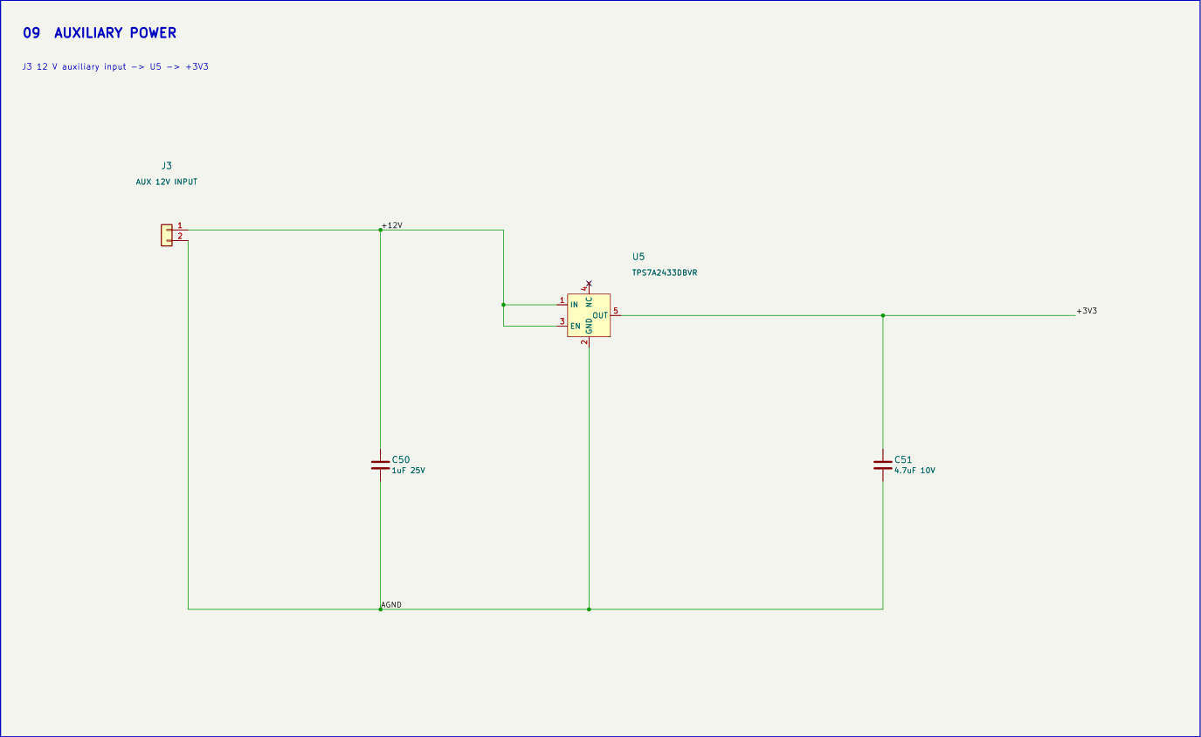
hardware/learning/previews/Module_09.png
