lunhuisheng/40W-CCM-Boost-PFC/hardware/learning/previews/Module_10.png

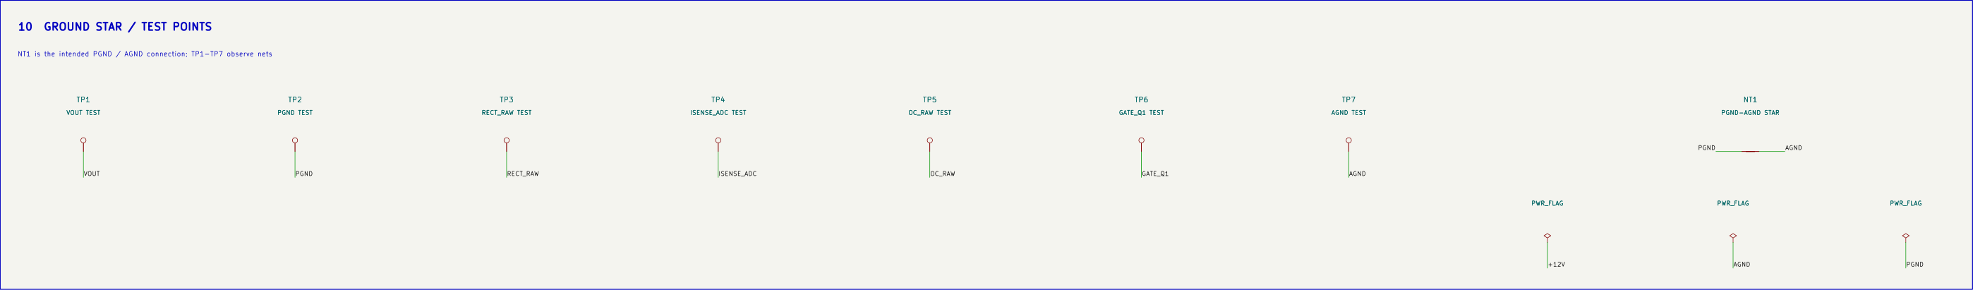
hardware/learning/previews/Module_10.png
