lunhuisheng/40W-CCM-Boost-PFC/simulation/BoostPFC_Design/results/load_step_responses.png

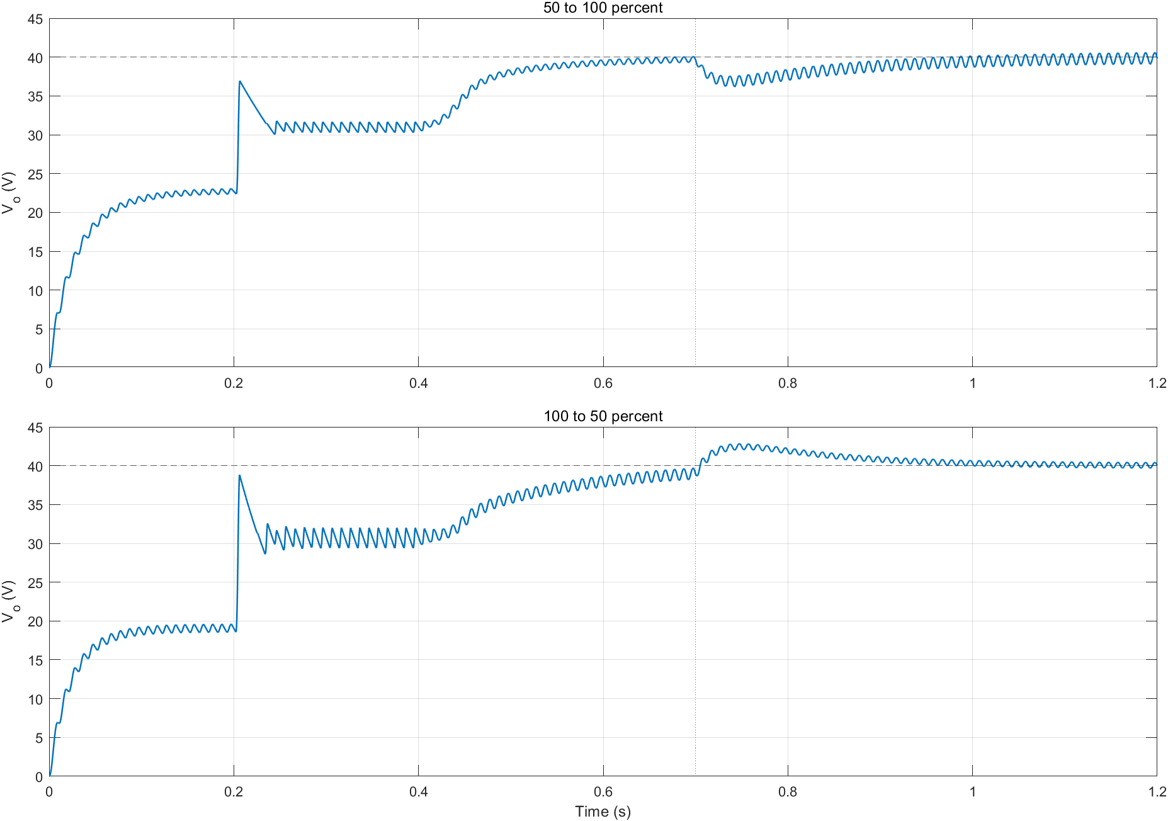
simulation/BoostPFC_Design/results/load_step_responses.png
