lunhuisheng/40W-CCM-Boost-PFC/simulation/BoostPFC_Design/results/controlled_startup/all_startup_strategy_comparison.png

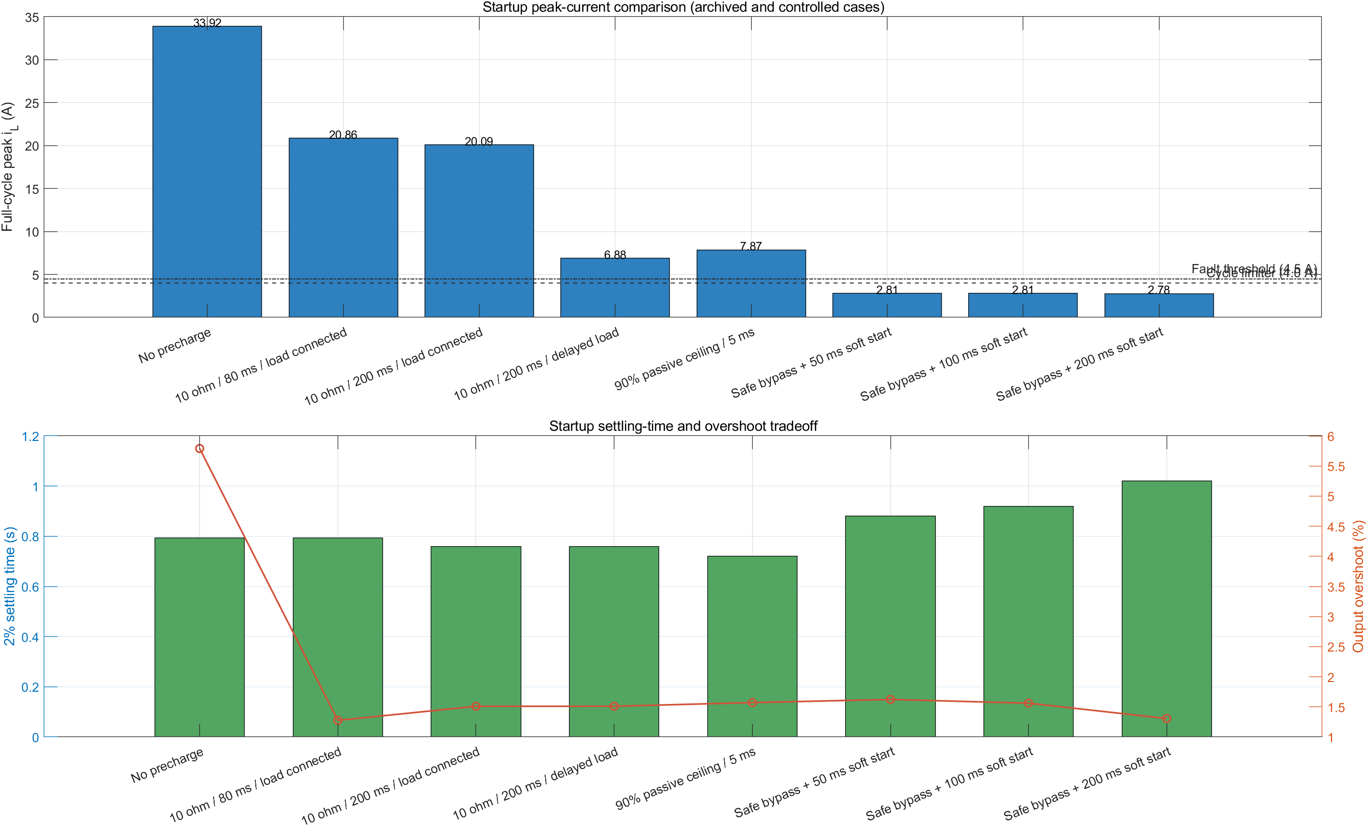
simulation/BoostPFC_Design/results/controlled_startup/all_startup_strategy_comparison.png
