lunhuisheng/40W-CCM-Boost-PFC/simulation/BoostPFC_Design/results/controlled_startup/controlled_startup_comparison.png

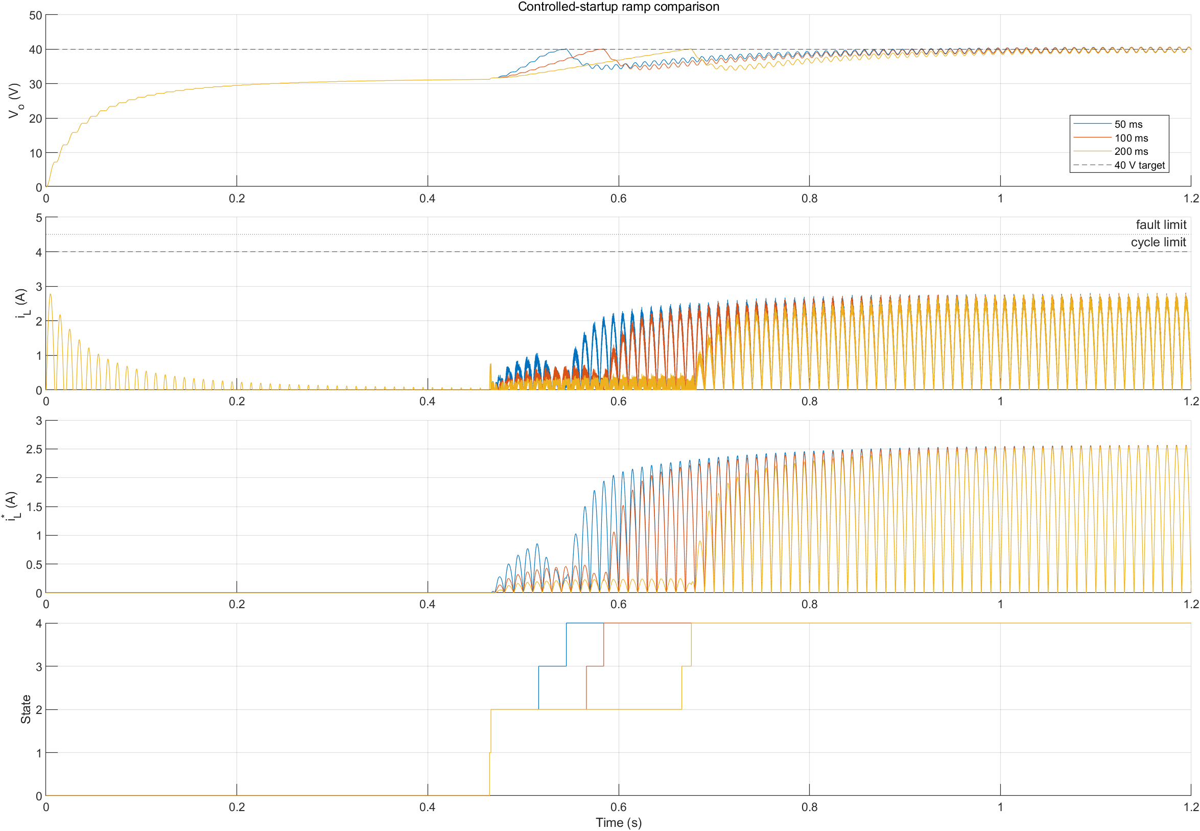
simulation/BoostPFC_Design/results/controlled_startup/controlled_startup_comparison.png
