lunhuisheng/40W-CCM-Boost-PFC/simulation/BoostPFC_Design/results/controlled_startup/protection_diagnostic.png

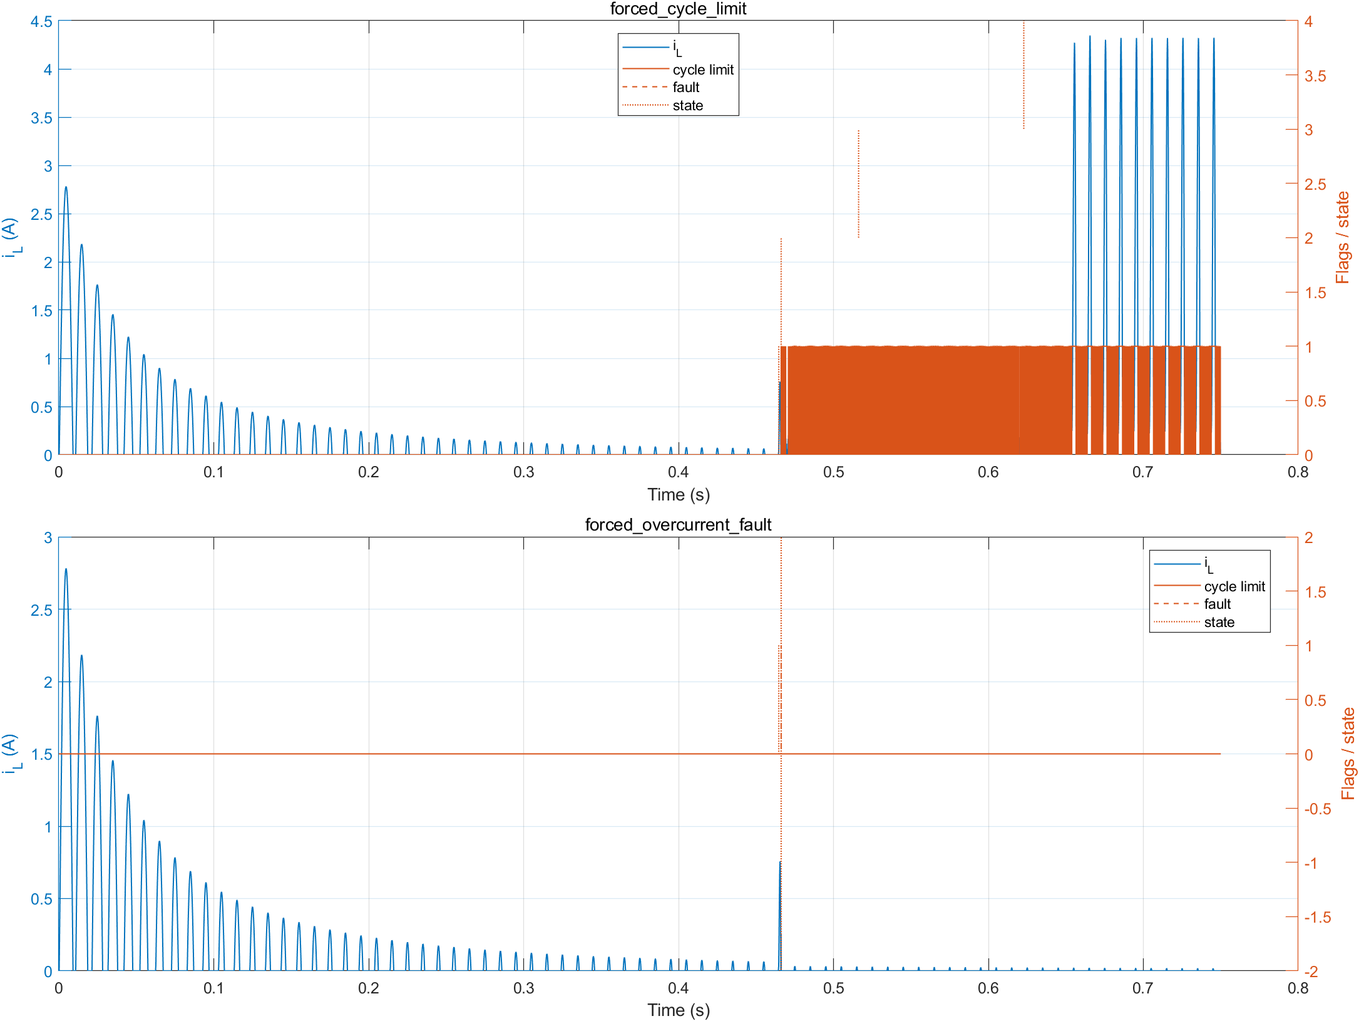
simulation/BoostPFC_Design/results/controlled_startup/protection_diagnostic.png
