lunhuisheng/40W-CCM-Boost-PFC/simulation/BoostPFC_Design/results/controlled_startup/ramp_050ms_waveforms.png

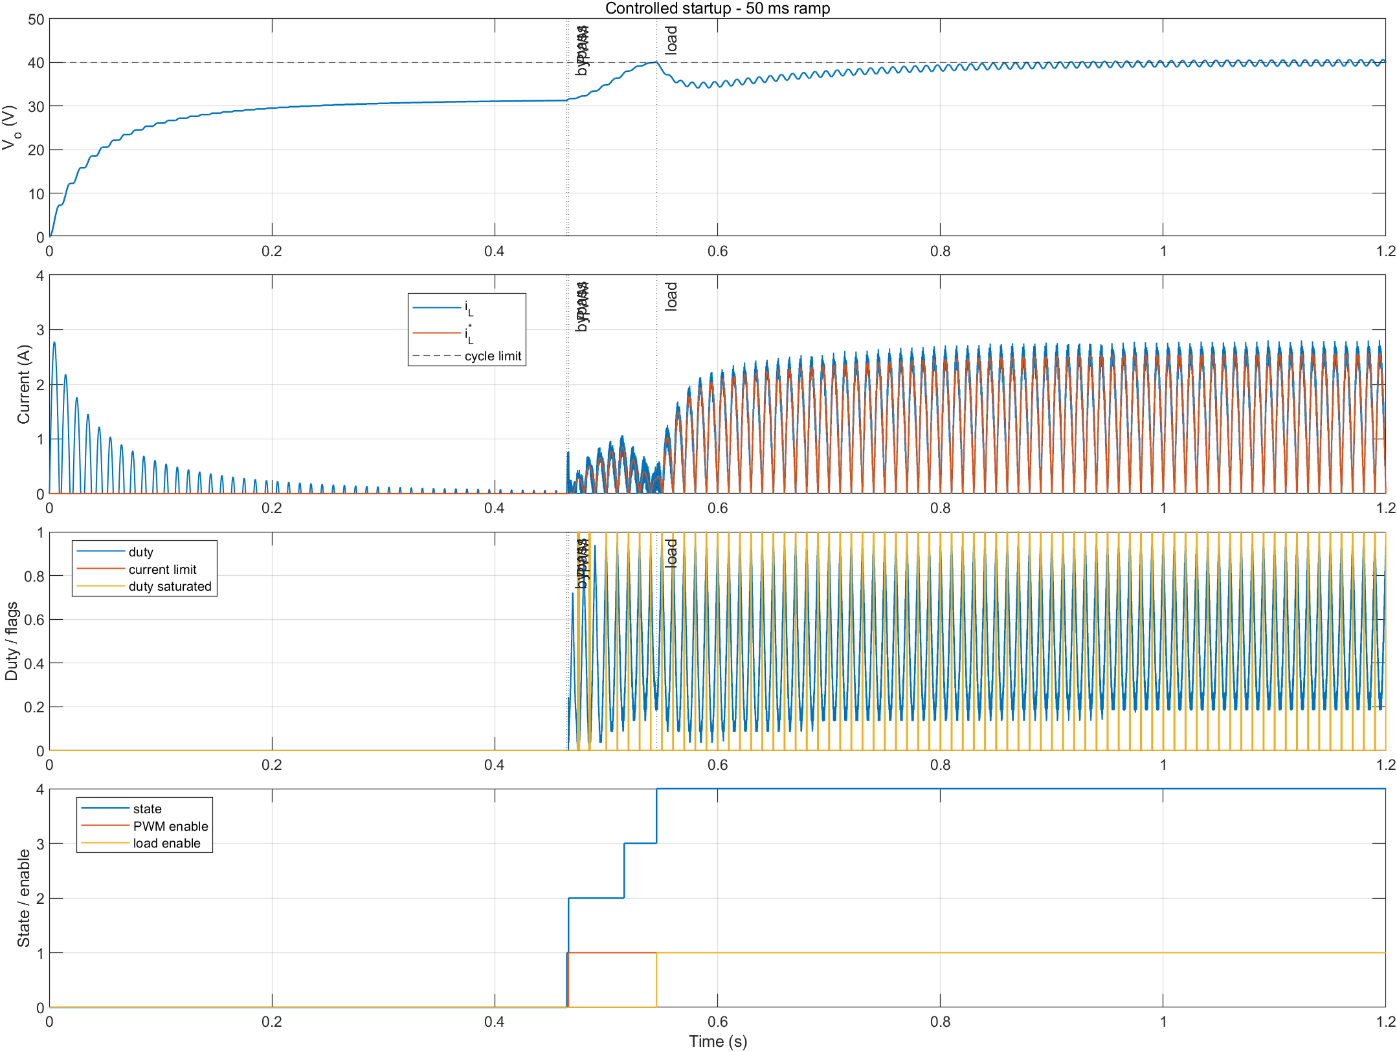
simulation/BoostPFC_Design/results/controlled_startup/ramp_050ms_waveforms.png
