lunhuisheng/40W-CCM-Boost-PFC/simulation/BoostPFC_Design/results/controlled_startup/ramp_200ms_waveforms.png

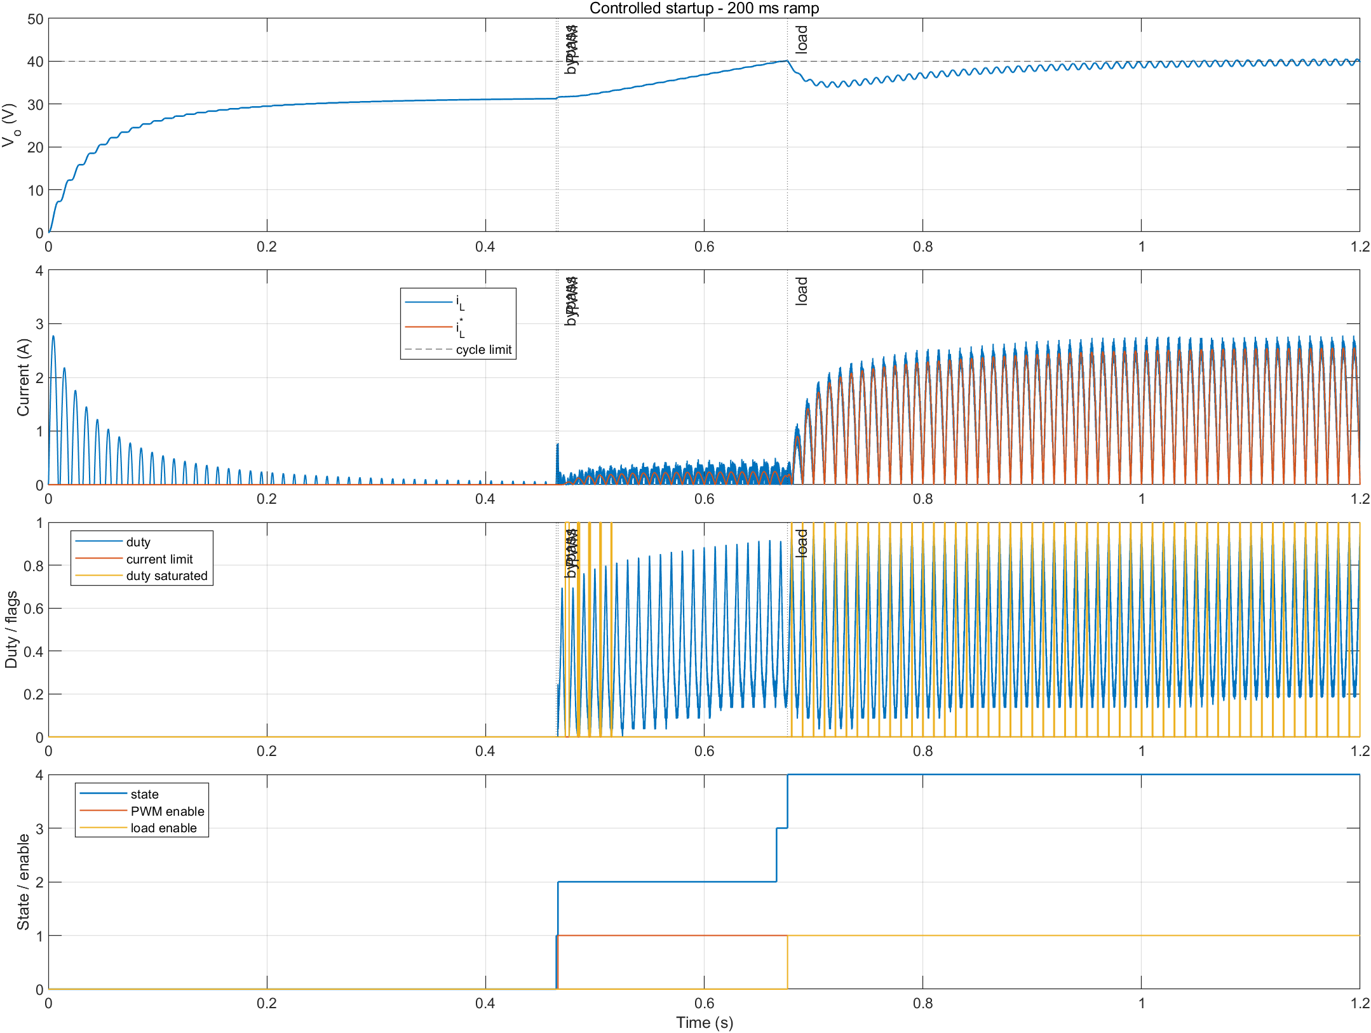
simulation/BoostPFC_Design/results/controlled_startup/ramp_200ms_waveforms.png
