lunhuisheng/40W-CCM-Boost-PFC/simulation/BoostPFC_Design/results/hold_up_test/line_peak_waveforms.png

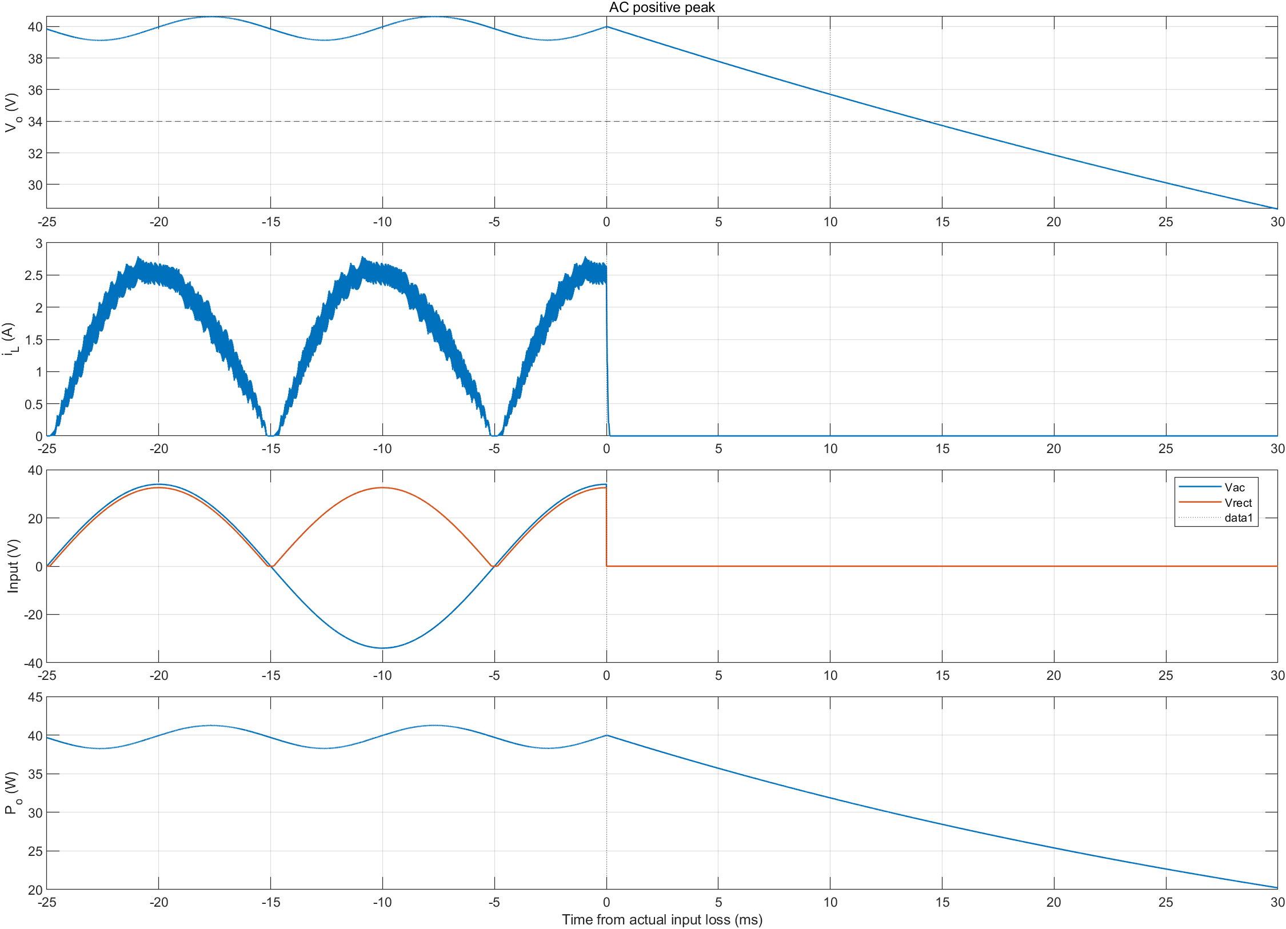
simulation/BoostPFC_Design/results/hold_up_test/line_peak_waveforms.png
