lunhuisheng/40W-CCM-Boost-PFC/simulation/BoostPFC_Design/results/hold_up_test/zero_crossing_waveforms.png

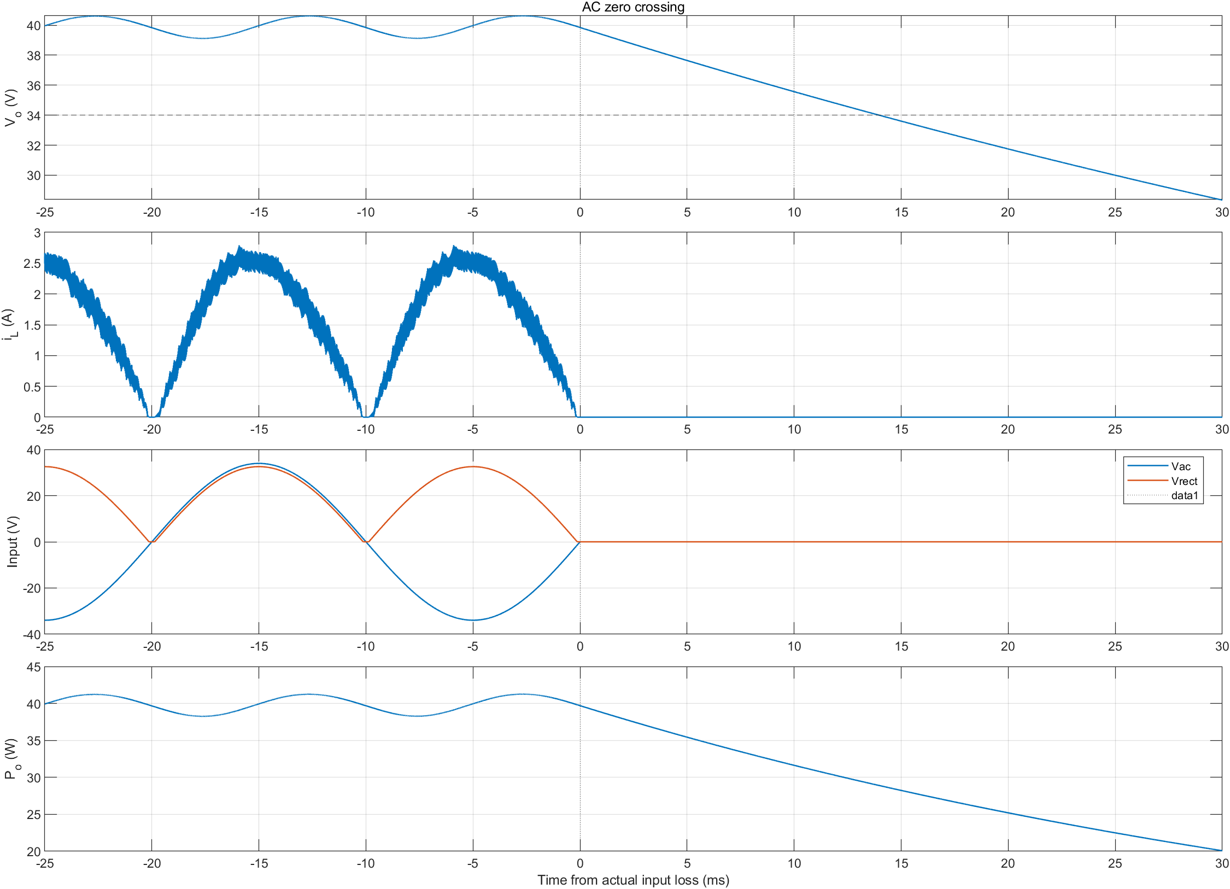
simulation/BoostPFC_Design/results/hold_up_test/zero_crossing_waveforms.png
