lunhuisheng/40W-CCM-Boost-PFC/simulation/BoostPFC_Design/results/input_voltage_comparison.png

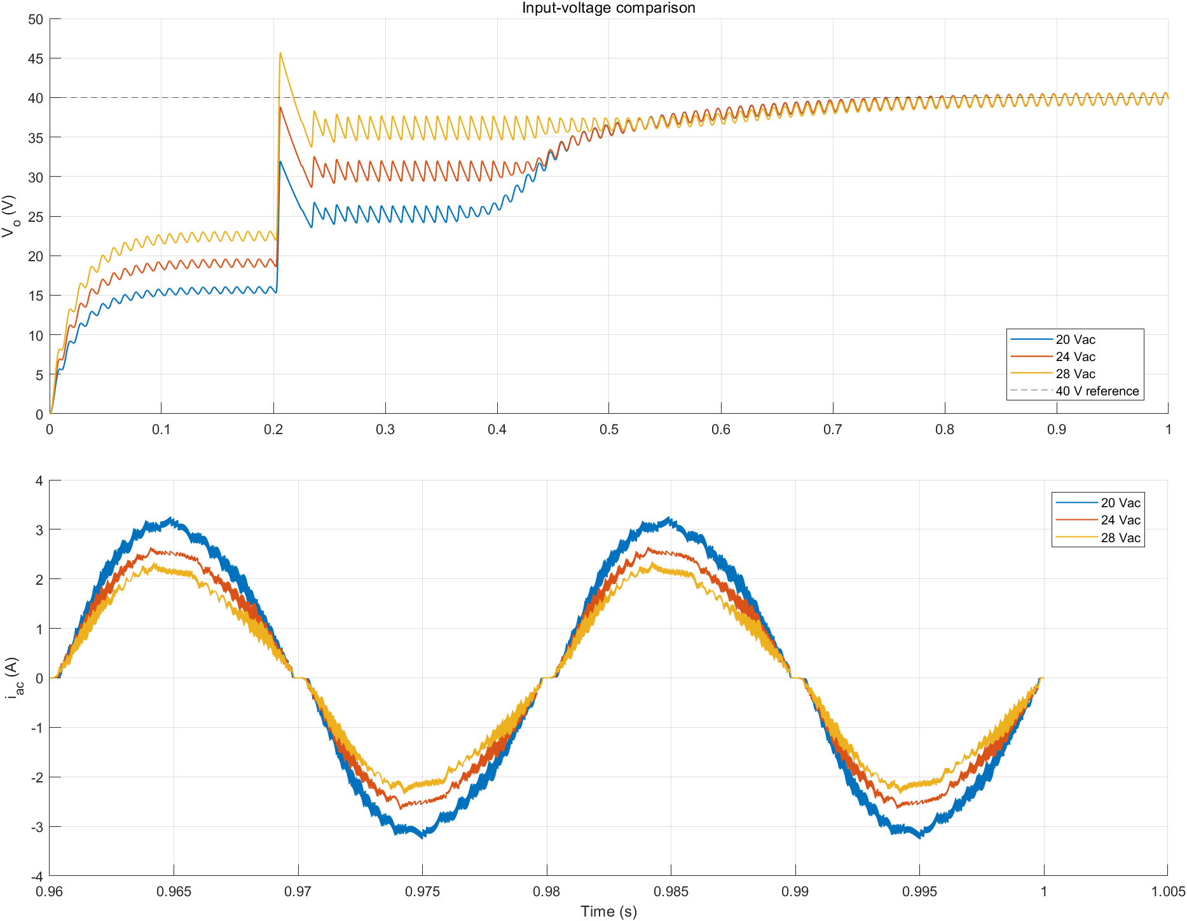
simulation/BoostPFC_Design/results/input_voltage_comparison.png
