lunhuisheng/40W-CCM-Boost-PFC/simulation/BoostPFC_Design/results/load_connection_study/conductance_ramp_80ms_waveforms.png

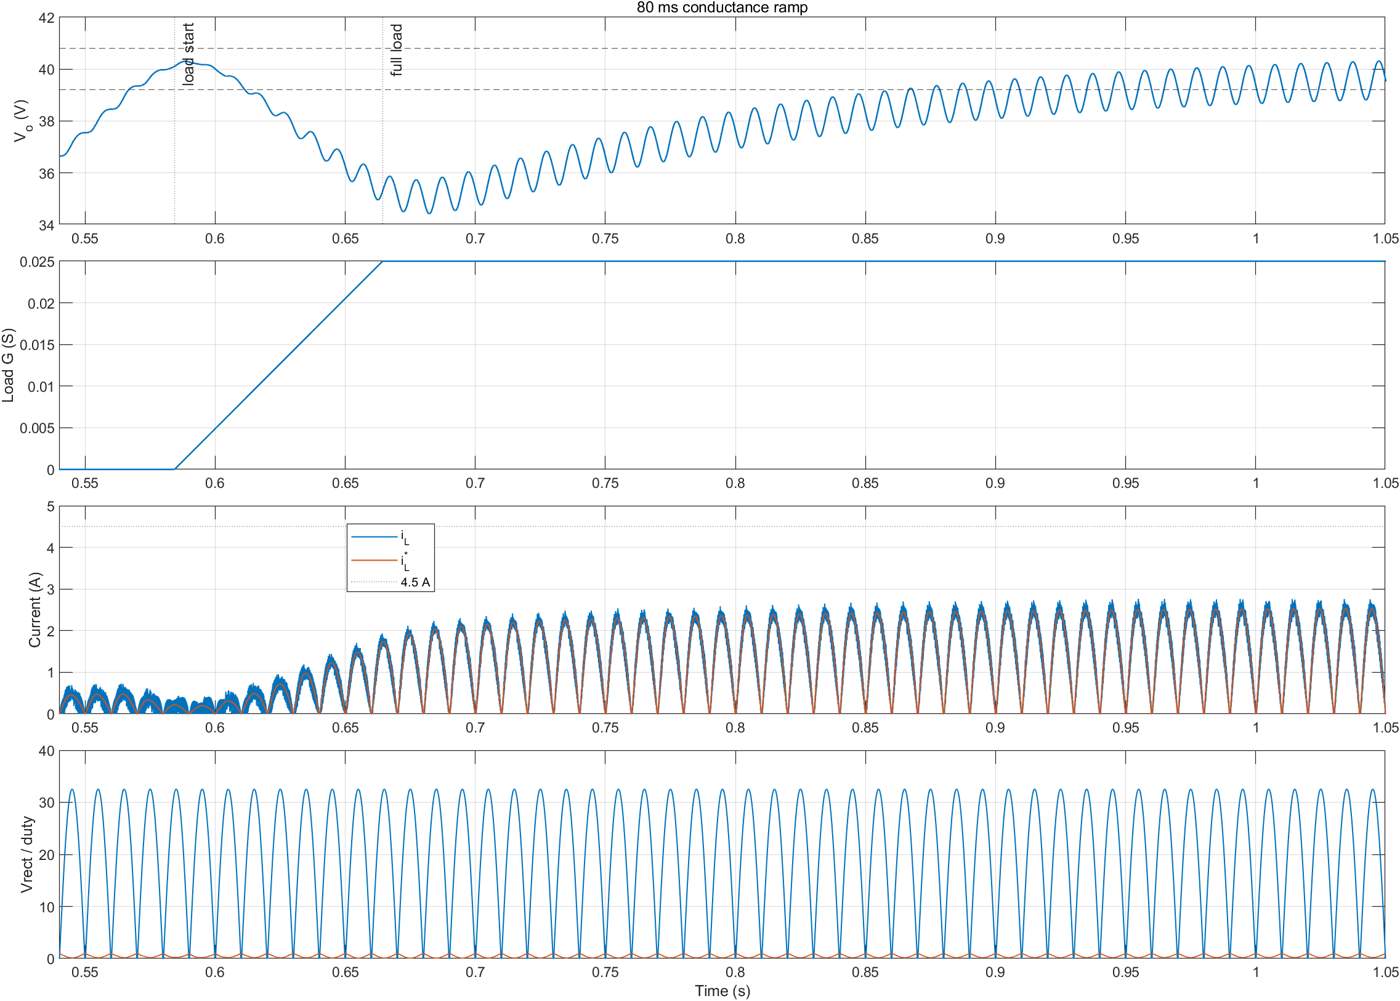
simulation/BoostPFC_Design/results/load_connection_study/conductance_ramp_80ms_waveforms.png
