lunhuisheng/40W-CCM-Boost-PFC/simulation/BoostPFC_Design/results/load_connection_study/direct_40ohm_waveforms.png

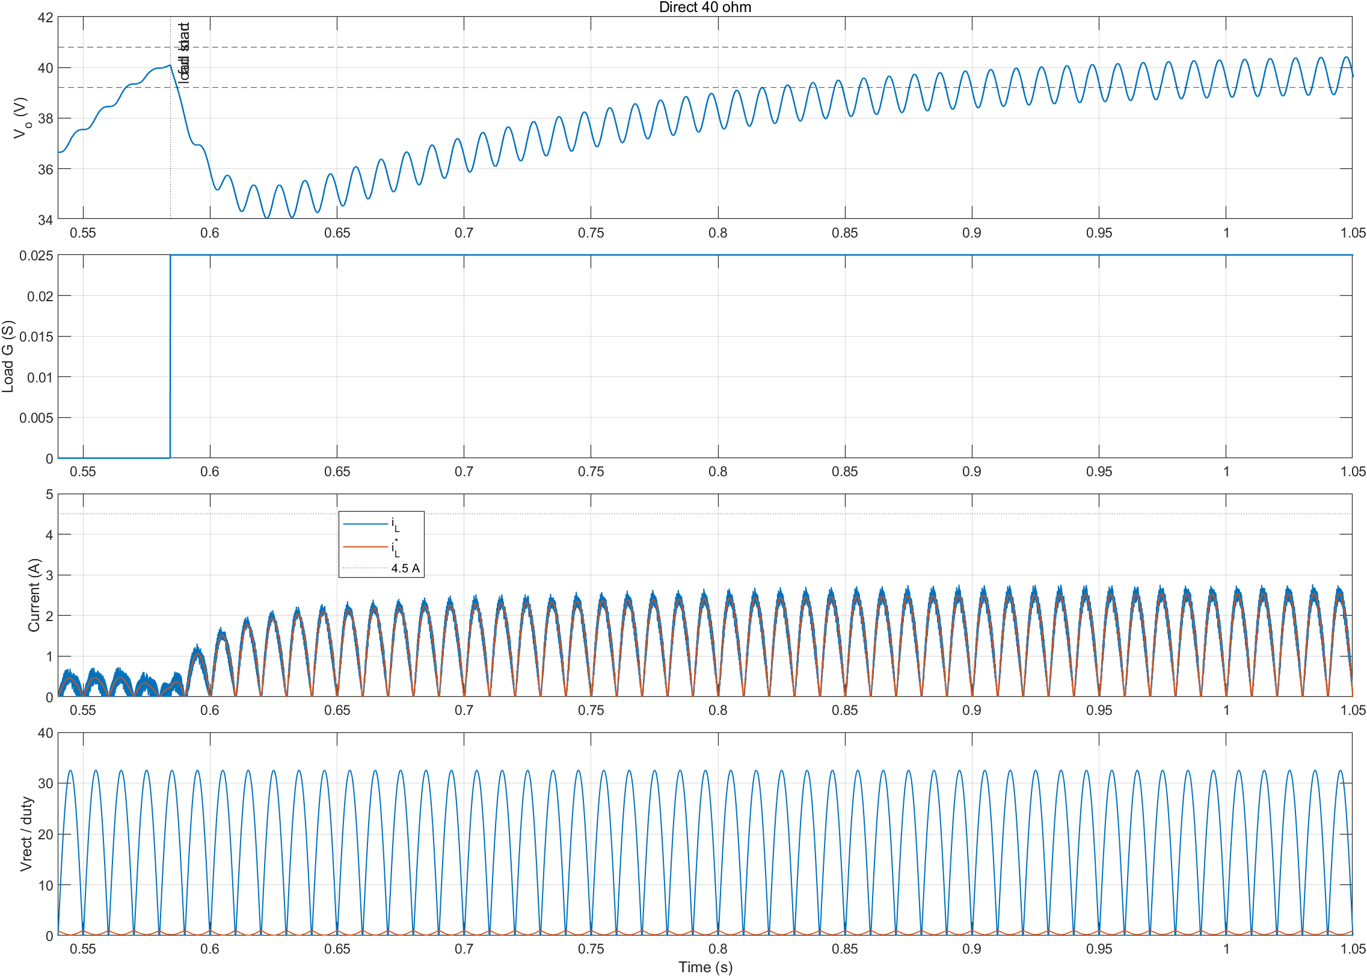
simulation/BoostPFC_Design/results/load_connection_study/direct_40ohm_waveforms.png
