lunhuisheng/40W-CCM-Boost-PFC/simulation/BoostPFC_Design/results/loop_audit/current_loop_delay_sensitivity_24Vac.png

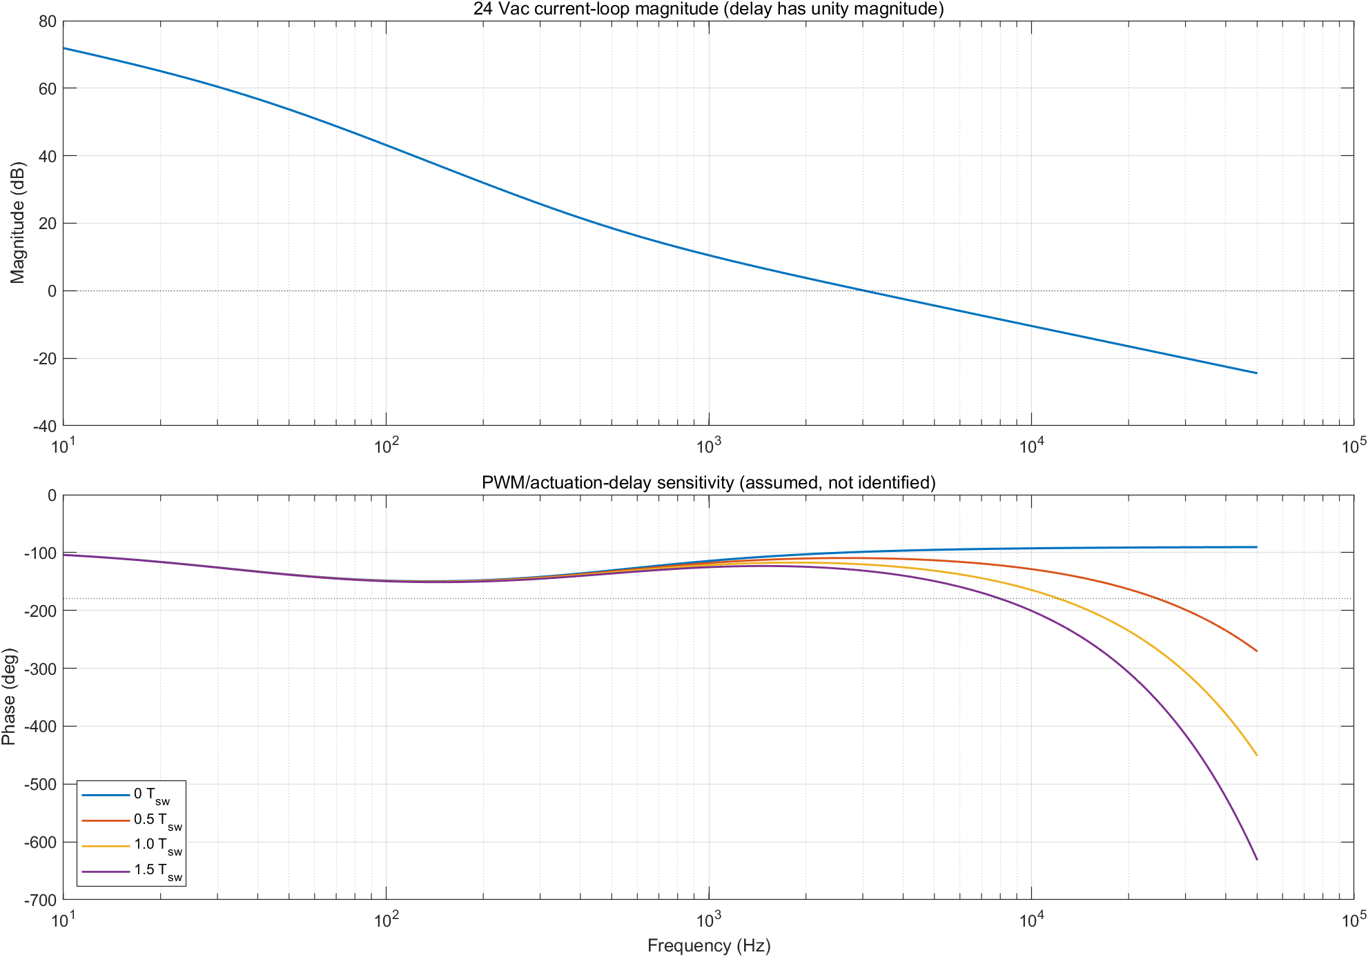
simulation/BoostPFC_Design/results/loop_audit/current_loop_delay_sensitivity_24Vac.png
