lunhuisheng/40W-CCM-Boost-PFC/simulation/BoostPFC_Design/results/loop_bode_margins.png

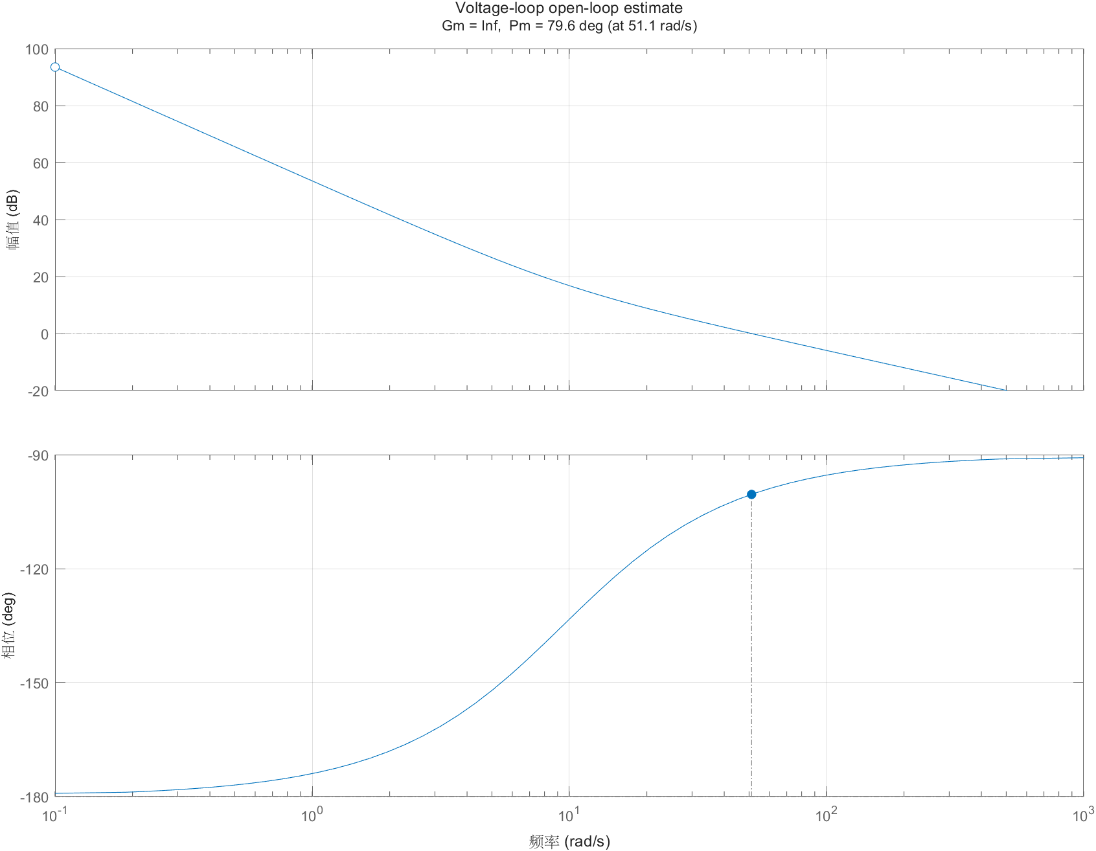
simulation/BoostPFC_Design/results/loop_bode_margins.png
