lunhuisheng/40W-CCM-Boost-PFC/simulation/BoostPFC_Design/results/nominal_24Vac_pfc_waveforms.png

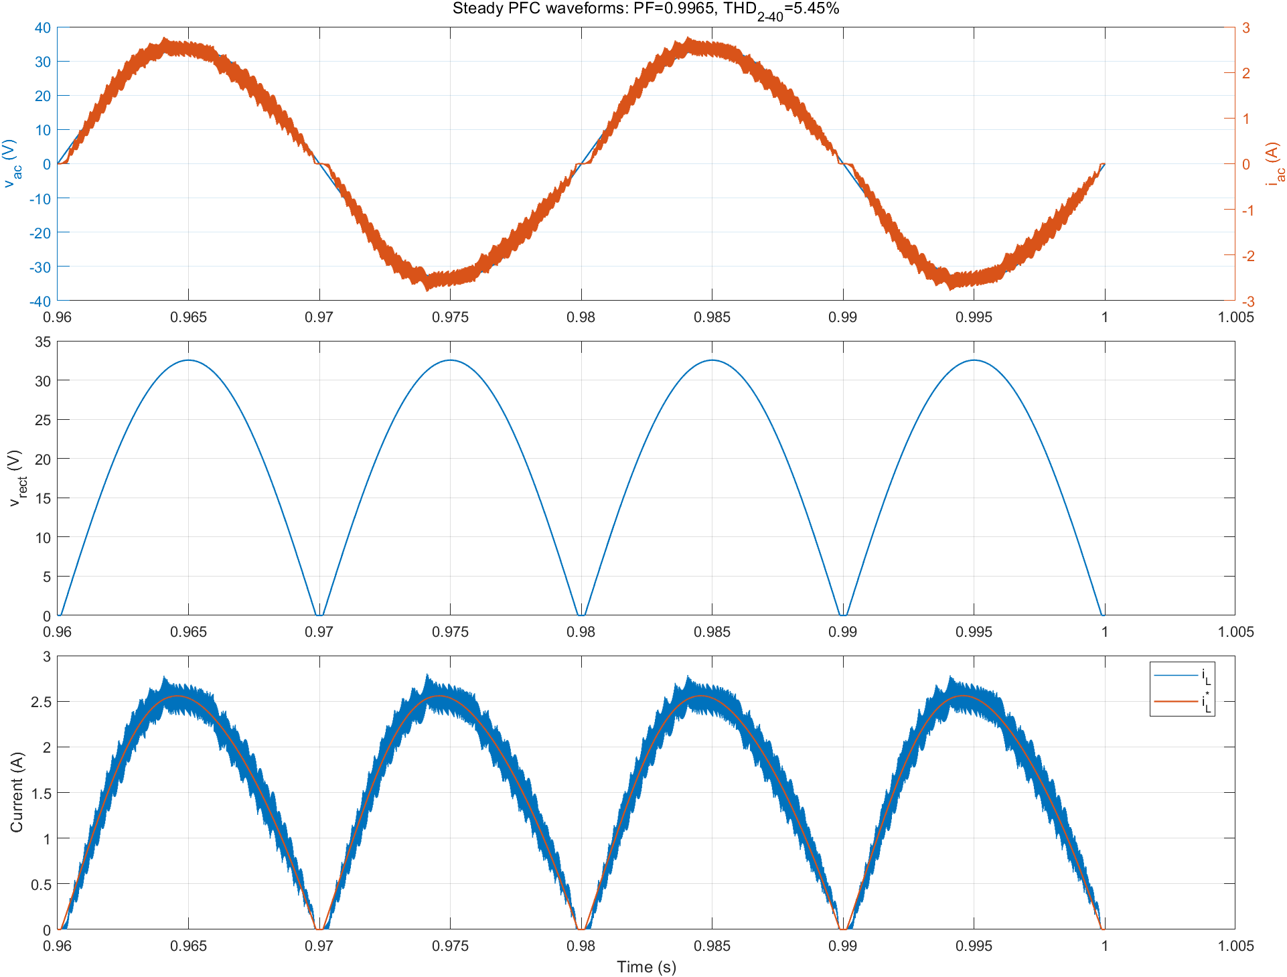
simulation/BoostPFC_Design/results/nominal_24Vac_pfc_waveforms.png
