lunhuisheng/40W-CCM-Boost-PFC/simulation/BoostPFC_Design/results/nominal_24Vac_startup.png

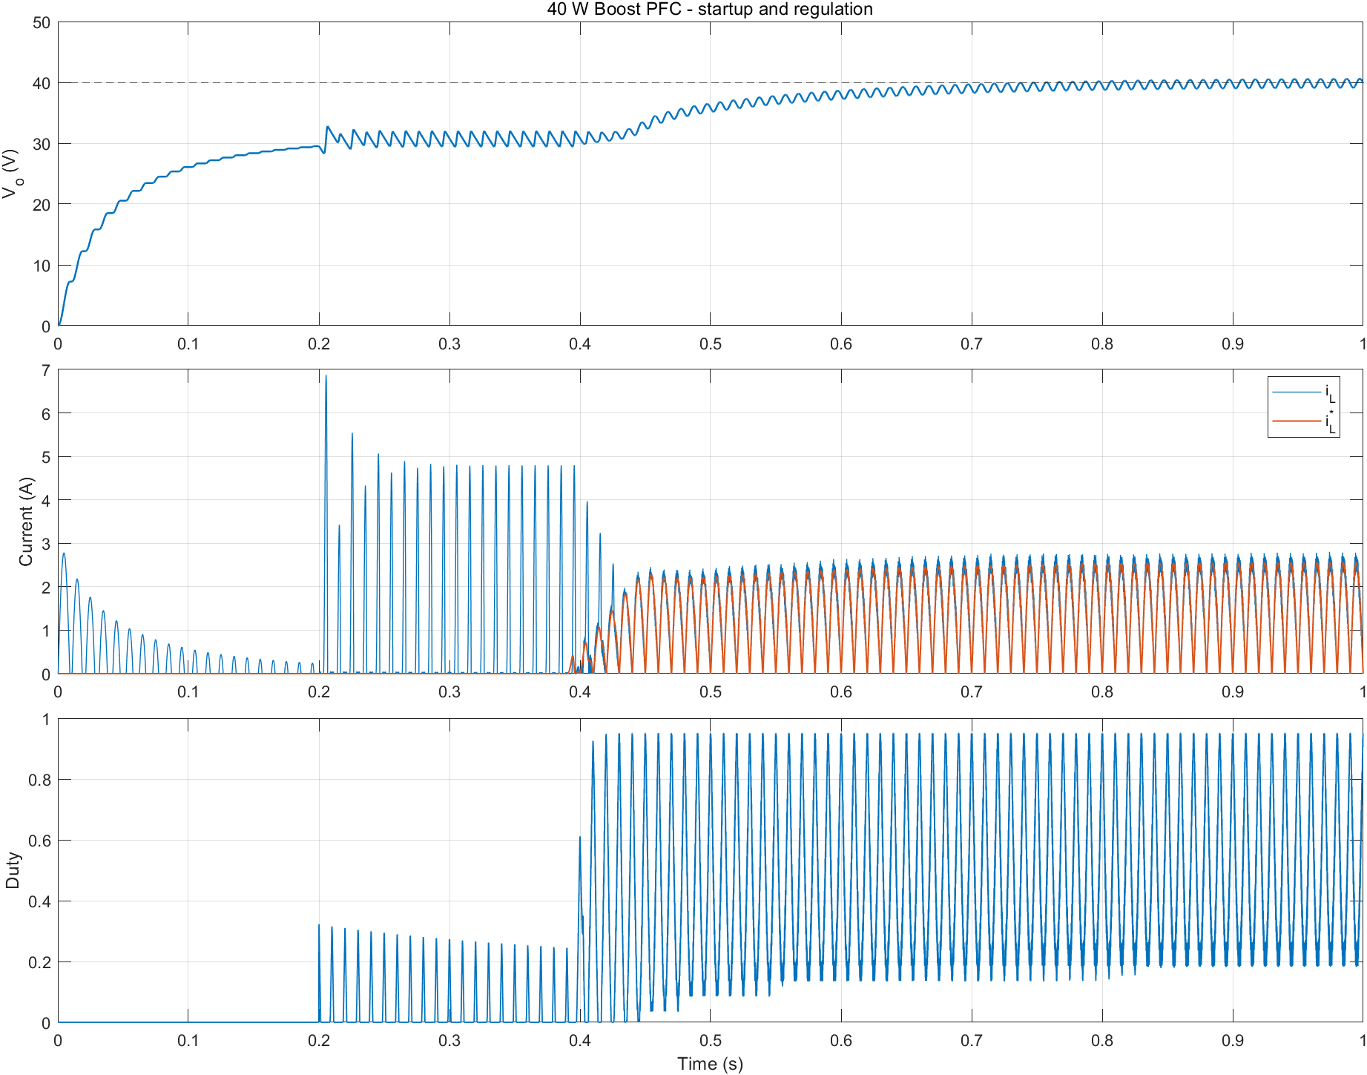
simulation/BoostPFC_Design/results/nominal_24Vac_startup.png
