lunhuisheng/40W-CCM-Boost-PFC/simulation/BoostPFC_Design/results/nominal_24Vac_switching_detail.png

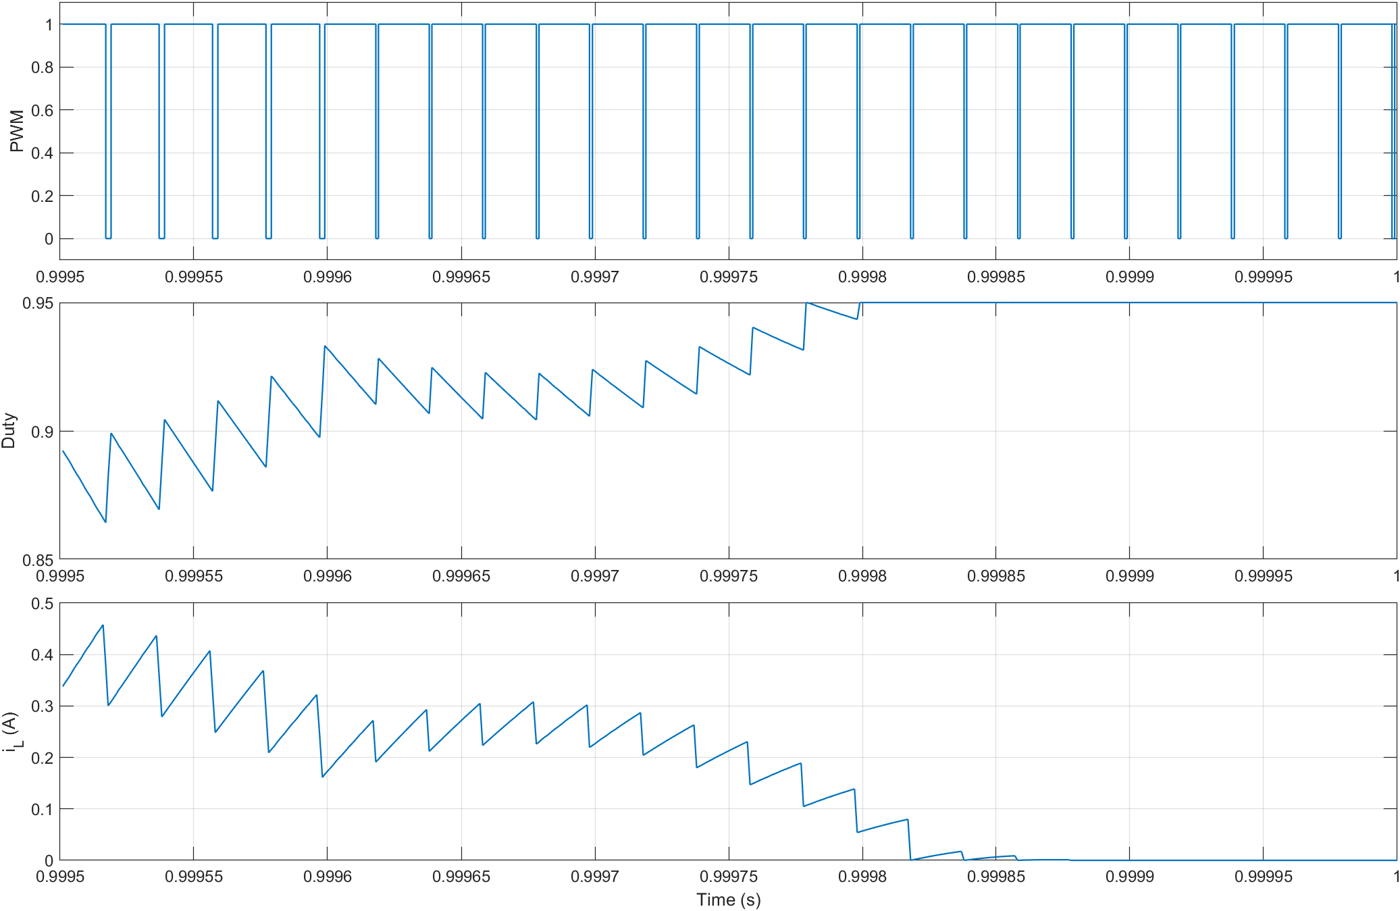
simulation/BoostPFC_Design/results/nominal_24Vac_switching_detail.png
