lunhuisheng/40W-CCM-Boost-PFC/simulation/BoostPFC_Design/results/safe_bypass/safe_bypass_waveforms.png

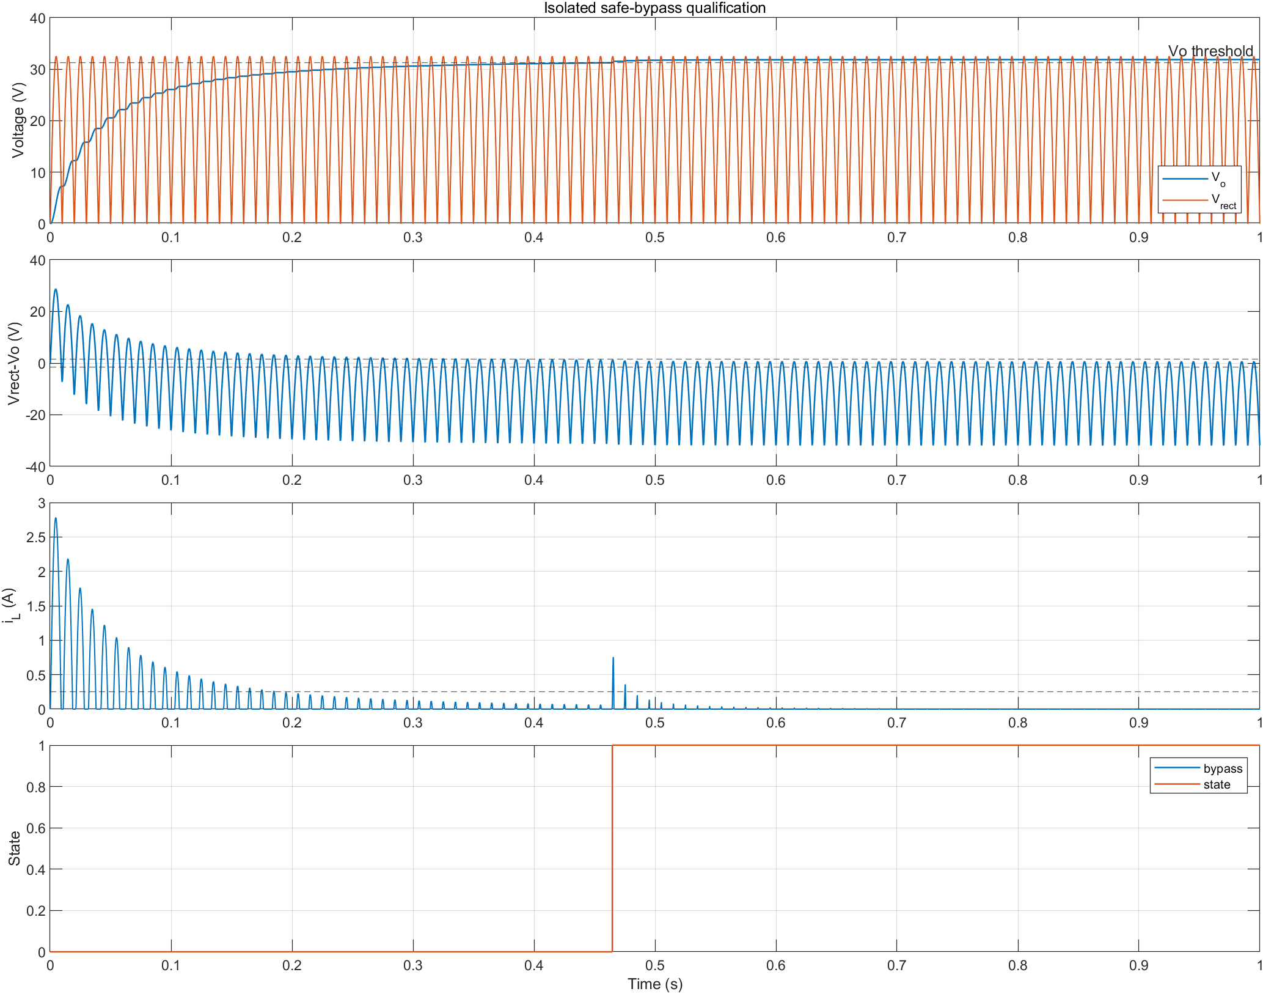
simulation/BoostPFC_Design/results/safe_bypass/safe_bypass_waveforms.png
