lunhuisheng/40W-CCM-Boost-PFC/simulation/BoostPFC_Design/results/startup_load_enable_comparison.png

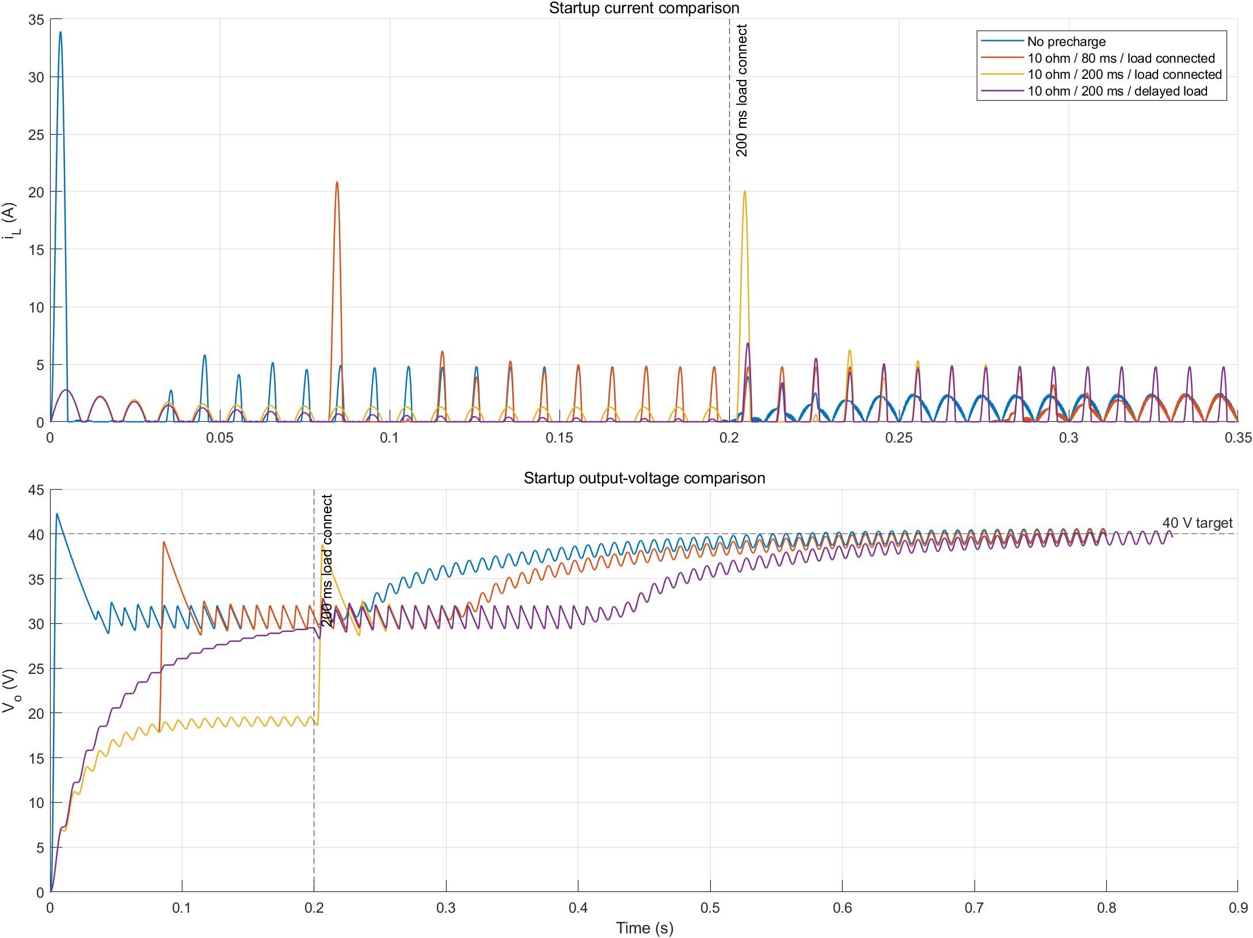
simulation/BoostPFC_Design/results/startup_load_enable_comparison.png
