lunhuisheng/40W-CCM-Boost-PFC/simulation/BoostPFC_Design/results/voltage_qualified/nominal_24Vac_startup.png

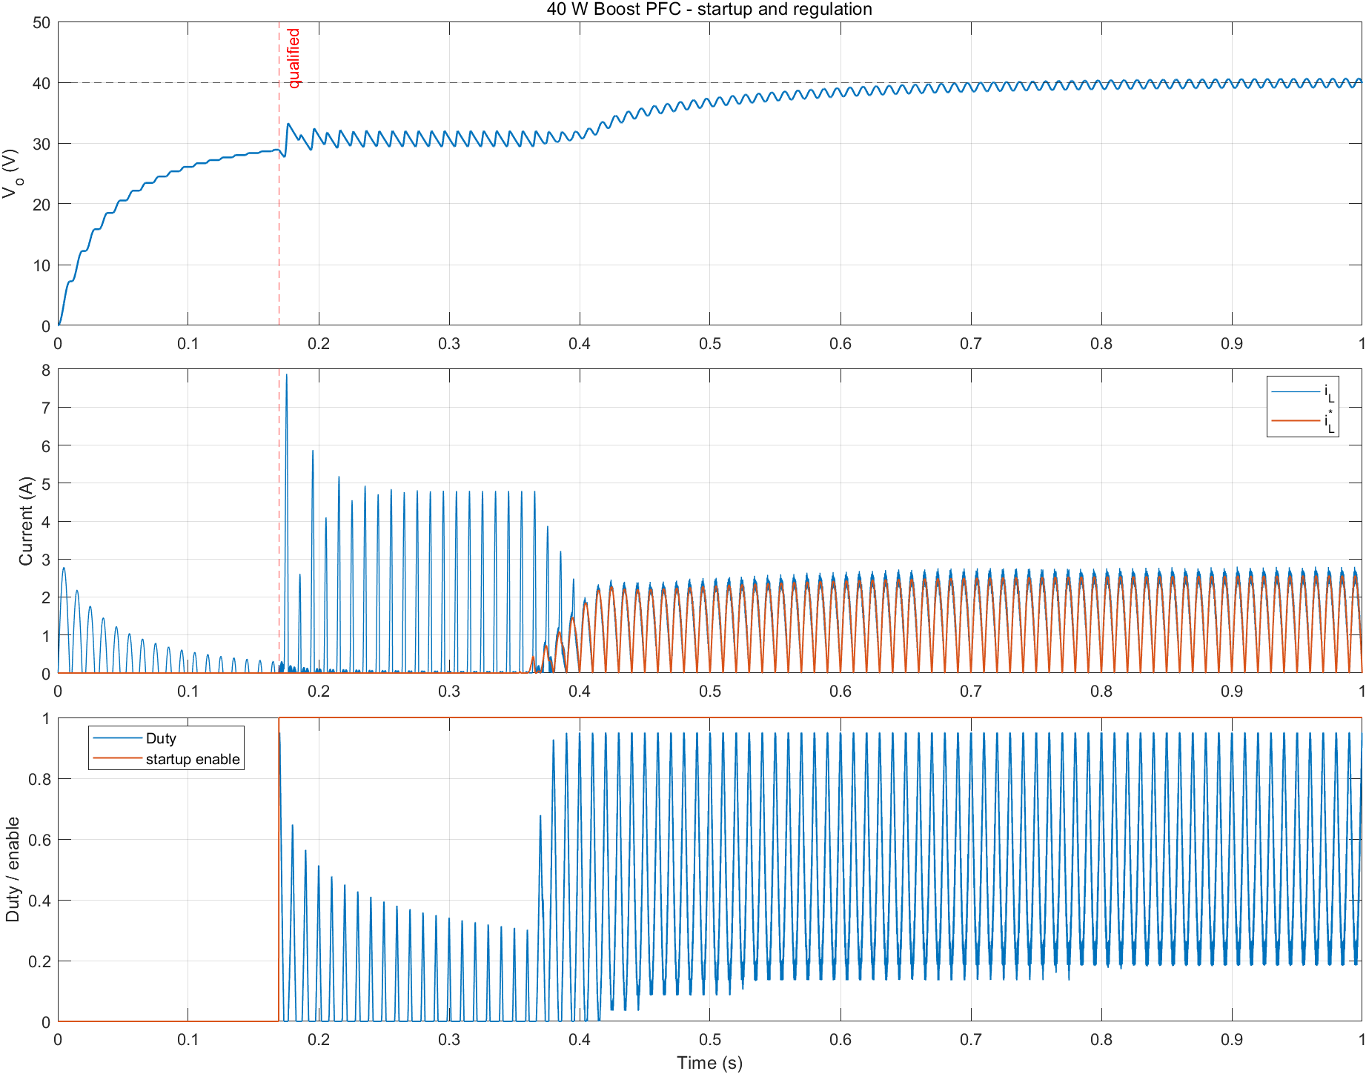
simulation/BoostPFC_Design/results/voltage_qualified/nominal_24Vac_startup.png
