lunhuisheng/40W-CCM-Boost-PFC/simulation/BoostPFC_Design/results/voltage_qualified/timeout_safety_test.png

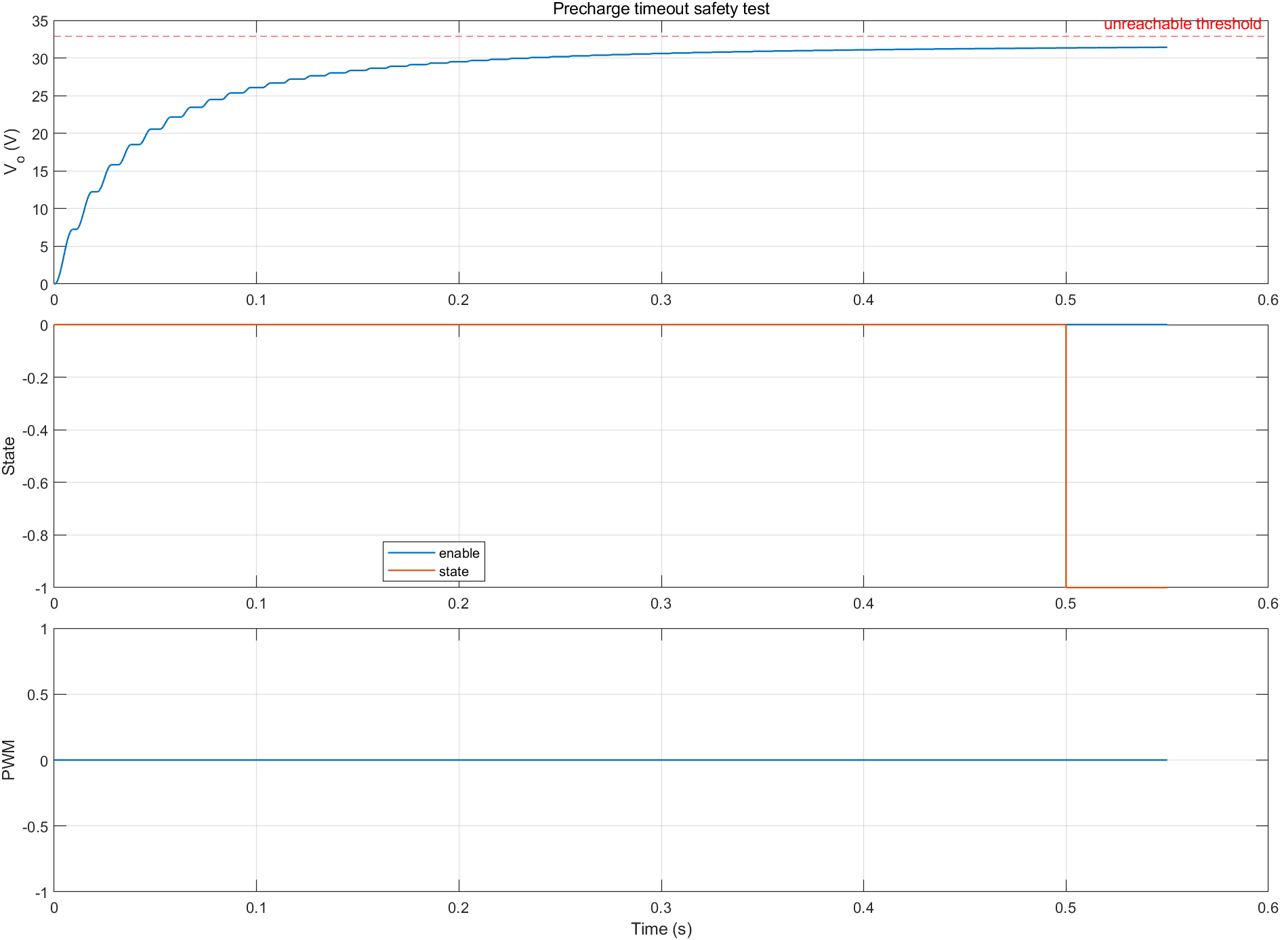
simulation/BoostPFC_Design/results/voltage_qualified/timeout_safety_test.png
