lunhuisheng/40W-CCM-Boost-PFC/simulation/BoostPFC_Design/results/voltage_qualified_startup_comparison.png

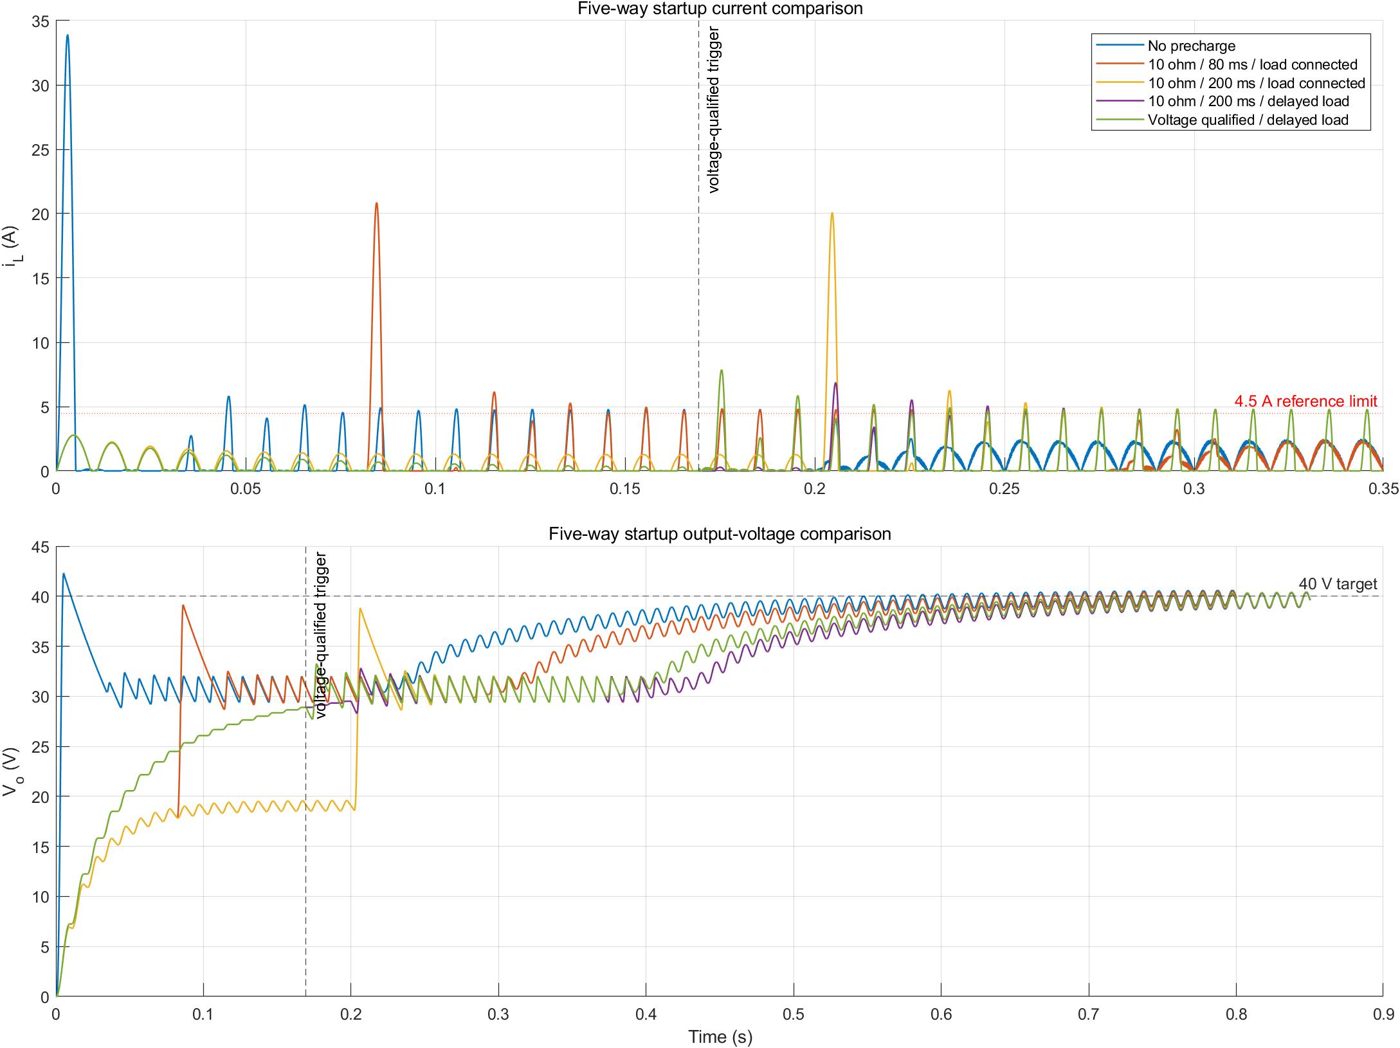
simulation/BoostPFC_Design/results/voltage_qualified_startup_comparison.png
