lunhuisheng/40W-CCM-Boost-PFC/hardware/learning/previews/BoostPFC_40W_WiredLearning.pdf

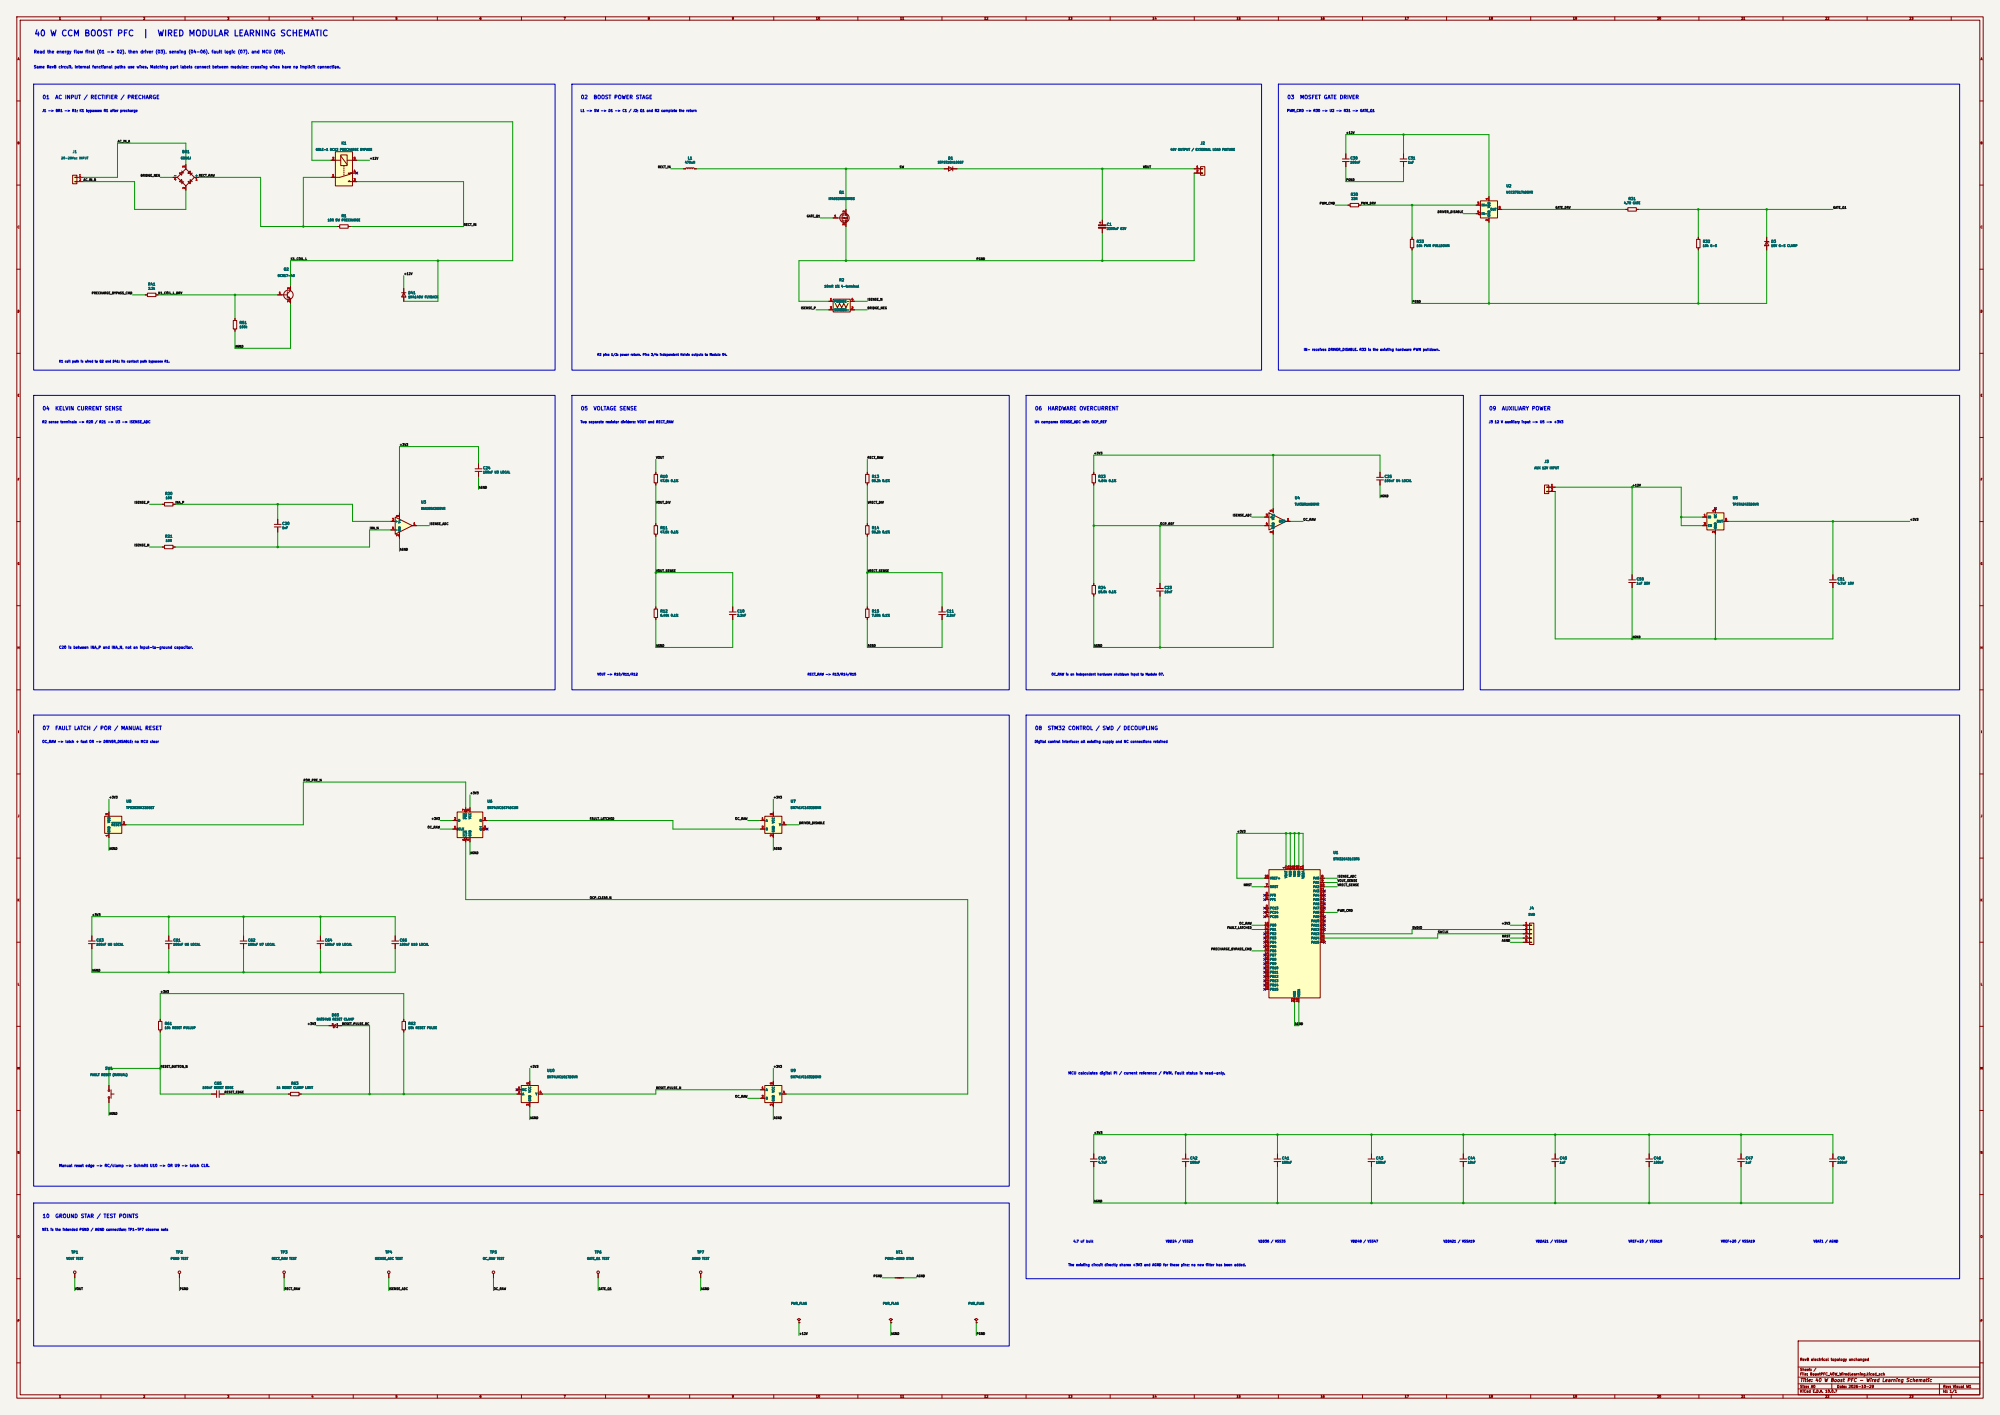
[picture p76: page 1]

40 W CCM BOOST PFC | WIRED MODULAR LEARNING SCHEMATIC

Read the energy flow first (01 -> 02), then driver (03), sensing (04-06), fault logic (07), and MCU (08).

Same RevB circuit. Internal functional paths use wires. Matching port labels connect between modules; crossing wires have no implicit connection.

01 AC INPUT / RECTIFIER / PRECHARGE

L1 -> SW -> D1 -> C1 / J2; Q1 and R2 complete the return 02 BOOST POWER STAGE

40V OUTPUT / EXTERNAL LOAD FIXTURE C1

40V OUTPUT / EXTERNAL LOAD FIXTURE 1

IN- receives DRIVER_DISABLE. R33 is the existing hardware PWM pulldown.

R2 pins 1/2: power return. Pins 3/4: independent Kelvin outputs to Module 04. 05 VOLTAGE SENSE

K1 coil path is wired to Q2 and D41; its contact path bypasses R1.

Two separate resistor dividers: VOUT and RECT_RAW

OC_RAW is an independent hardware shutdown input to Module 07.

Digital control interface; all existing supply and NC connections retained

+3V3NRST OC_RAW
RevB electrical topology unchanged VBAT 1 PC13

MCU calculates digital PI / current reference / PWM. Fault status is read-only.

VREF+20 / VSSA19 10 GROUND STAR / TEST POINTS

NT1 is the intended PGND / AGND connection; TP1-TP7 observe nets

Sheet: /
File: BoostPFC_40W_WiredLearning.kicad_sch
Title: 40 W Boost PFC - Wired Learning Schematic

Size: A0 | Rev: Visual W1
KiCad E.D.A. 10.0.7 | Id: 1/1
