lunhuisheng/40W-CCM-Boost-PFC/hardware/latest/BoostPFC_40W_RevB.kicad_pcb

## KiCad design hardware/latest/BoostPFC_40W_RevB.kicad_pcb (2026-10-29)

Schematic: BoostPFC_40W_RevB.kicad_sch, 40 W Boost PFC - Wired Learning Schematic

Parts:
BR1: GBU6J; Diode_Bridge_Vishay_GBU; MPN GBU6J-E3/45
C1: 2200uF 63V; CP_Radial_D18.0mm_P7.50mm; MPN 63PX2200MEFC18X31.5
C10, C11: 2.2nF; C_0603_1608Metric
C20: 1nF; C_0603_1608Metric
C23, C44: 10nF; C_0603_1608Metric
C24: 100nF U3 LOCAL; C_0603_1608Metric
C25: 100nF U4 LOCAL; C_0603_1608Metric
C30, C41, C42, C43, C46, C48: 100nF; C_0603_1608Metric
C31, C45, C47: 1uF; C_0805_2012Metric
C40: 4.7uF; C_0805_2012Metric
C50: 1uF 25V; C_0805_2012Metric
C51: 4.7uF 10V; C_0805_2012Metric
C61: 100nF U6 LOCAL; C_0603_1608Metric
C62: 100nF U7 LOCAL; C_0603_1608Metric
C63: 100nF U8 LOCAL; C_0603_1608Metric
C64: 100nF U9 LOCAL; C_0603_1608Metric
C65: 100nF RESET EDGE; C_0603_1608Metric
C66: 100nF U10 LOCAL; C_0603_1608Metric
D1: STPST10H100SF; TO-277A; MPN STPST10H100SF
D3: 15V G-S CLAMP; D_SOD-123
D41: 1N4148W FLYBACK; D_SOD-123
D65: BAT54WS RESET CLAMP; D_SOD-323; MPN BAT54WS-7-F
J1: 20-28Vac INPUT; PhoenixContact_MSTBA_2,5_2-G-5,08_1x02_P5.08mm_Horizontal; MPN 1757242
J2: 40V OUTPUT / EXTERNAL LOAD FIXTURE; PhoenixContact_MSTBA_2,5_2-G-5,08_1x02_P5.08mm_Horizontal; MPN 1757242
J3: AUX 12V INPUT; PhoenixContact_MSTBA_2,5_2-G-5,08_1x02_P5.08mm_Horizontal; MPN 1757242
J4: SWD; PinHeader_1x05_P2.54mm_Vertical
K1: G5LE-1 DC12 PRECHARGE BYPASS; Relay_SPDT_Omron-G5LE-1; MPN G5LE-1 DC12
L1: 470uH; Bourns_1140-471K-RC; MPN 1140-471K-RC
NT1: PGND-AGND STAR; NetTie-2_SMD_Pad2.0mm
Q1: IPA052N08NM5S; TO-220-3_Vertical; MPN IPA052N08NM5SXKSA1
Q2: BC817-40; SOT-23; MPN BC817-40,215
R1: 10R 5W PRECHARGE; R_Axial_Power_L20.0mm_W6.4mm_P22.40mm; MPN AC05000001009JAC00
R2: 10mR 1% 4-terminal; Vishay_WSK2512_4Terminal_10mR; MPN WSK2512R0100FEA
R10, R11: 47.5k 0.1%; R_0603_1608Metric
R12: 6.49k 0.1%; R_0603_1608Metric
R13, R14: 56.2k 0.1%; R_0603_1608Metric
R15: 7.50k 0.1%; R_0603_1608Metric
R20, R21: 10R; R_0603_1608Metric
R23: 4.64k 0.1%; R_0603_1608Metric
R24: 10.0k 0.1%; R_0603_1608Metric
R30: 33R; R_0603_1608Metric
R31: 4.7R GATE; R_0603_1608Metric
R32: 10k G-S; R_0603_1608Metric
R33: 10k PWM PULLDOWN; R_0603_1608Metric
R41: 2.2k; R_0603_1608Metric
R51: 100k; R_0603_1608Metric
R61: 10k RESET PULLUP; R_0603_1608Metric
R62: 10k RESET PULSE; R_0603_1608Metric
R63: 1k RESET CLAMP LIMIT; R_0603_1608Metric
SW1: FAULT RESET (MANUAL); SW_PUSH_6mm
TP1: VOUT TEST; TestPoint_Loop_D2.50mm_Drill1.0mm
TP2: PGND TEST; TestPoint_Loop_D2.50mm_Drill1.0mm
TP3: RECT_RAW TEST; TestPoint_Loop_D2.50mm_Drill1.0mm
TP4: ISENSE_ADC TEST; TestPoint_Loop_D2.50mm_Drill1.0mm
TP5: OC_RAW TEST; TestPoint_Loop_D2.50mm_Drill1.0mm
TP6: GATE_Q1 TEST; TestPoint_Loop_D2.50mm_Drill1.0mm
TP7: AGND TEST; TestPoint_Loop_D2.50mm_Drill1.0mm
U1: STM32G431CBT6; LQFP-48_7x7mm_P0.5mm; MPN STM32G431CBT6
U2: UCC27517ADBVR; SOT-23-5; MPN UCC27517ADBVR
U3: INA180A2IDBVR; SOT-23-5; MPN INA180A2IDBVR
U4: TLV3201AIDBVR; SOT-23-5; MPN TLV3201AIDBVR
U5: TPS7A2433DBVR; SOT-23-5; MPN TPS7A2433DBVR
U6: SN74LVC1G74DCUR; VSSOP-8_2.3x2mm_P0.5mm; MPN SN74LVC1G74DCUR
U7, U9: SN74LVC1G32DBVR; SOT-23-5; MPN SN74LVC1G32DBVR
U8: TPS3839K33DBZT; SOT-23; MPN TPS3839K33DBZT
U10: SN74LVC1G17DBVR; SOT-23-5; MPN SN74LVC1G17DBVR

Connections:
/+3V3: C24.1, C25.1, C40.1, C41.1, C42.1, C43.1, C44.1, C45.1, C46.1, C47.1, C48.1, C51.1, C61.1, C62.1, C63.1, C64.1, C66.1, D65.1 (K), J4.1, R23.1, R61.1, R62.1, U1.1 (VBAT), U1.20 (VREF+), U1.21 (VDDA), U1.24 (VDD), U1.36 (VDD), U1.48 (VDD), U3.5 (V+), U4.5 (VCC), U5.5 (OUT), U6.2 (D), U6.8 (VCC), U7.5 (VCC), U8.3 (VDD), U9.5 (VCC), U10.5 (VCC)
/+12V: C30.1, C31.1, C50.1, D41.1 (K), J3.1, K1.5, U2.1 (VDD), U5.1 (IN), U5.3 (EN)
/AC_IN_A: BR1.3, J1.1
/AC_IN_B: BR1.2, J1.2
/AGND: C10.2, C11.2, C23.2, C24.2, C25.2, C40.2, C41.2, C42.2, C43.2, C44.2, C45.2, C46.2, C47.2, C48.2, C50.2, C51.2, C61.2, C62.2, C63.2, C64.2, C66.2, J3.2, J4.5, NT1.2, Q2.2 (E), R12.2, R15.2, R24.2, R51.2, SW1.2, TP7.1, U1.19 (VSSA), U1.23 (VSS), U1.35 (VSS), U1.47 (VSS), U3.2 (GND), U4.2 (GND), U5.2 (GND), U6.4 (GND), U7.3 (GND), U8.1 (GND), U9.3 (GND), U10.3 (GND)
/BRIDGE_NEG: BR1.4 (-), R2.2 (PWR-)
/DRIVER_DISABLE: U2.4 (IN-), U7.4 (Y)
/FAULT_LATCHED: U1.17 (PB1), U6.5 (Q), U7.2 (B)
/GATE_DRV: R31.1, U2.5 (OUT)
/GATE_Q1: D3.1 (K), Q1.1 (G), R31.2, R32.1, TP6.1
/INA_N: C20.2, R21.2, U3.4 (-)
/INA_P: C20.1, R20.2, U3.3 (+)
/ISENSE_ADC: TP4.1, U1.8 (PA0), U3.1, U4.3 (+)
/ISENSE_N: R2.4 (SENSE-), R21.1
/ISENSE_P: R2.3 (SENSE+), R20.1
/K1_COIL_L: D41.2 (A), K1.2, Q2.3 (C)
/K1_COIL_L_DRV: Q2.1 (B), R41.2, R51.1
/NRST: J4.4, U1.7 (NRST)
/OCP_CLEAR_N: U6.6 (~CLR), U9.4 (Y)
/OCP_REF: C23.1, R23.2, R24.1, U4.4 (-)
/OC_RAW: TP5.1, U1.16 (PB0), U4.1 (OUT), U6.1 (CLK), U7.1 (A), U9.2 (B)
/PGND: C1.2, C30.2, C31.2, D3.2 (A), J2.2, NT1.1, Q1.3 (S), R2.1 (PWR+), R32.2, R33.2, TP2.1, U2.2 (GND)
/POR_PRE_N: U6.7 (~PRE), U8.2 (~RESET)
/PRECHARGE_BYPASS_CMD: R41.1, U1.43 (PB6)
/PWM_CMD: R30.1, U1.30 (PA8)
/PWM_DRV: R30.2, R33.1, U2.3 (IN+)
/RECT_IN: K1.3, L1.1, R1.2
/RECT_RAW: BR1.1 (+), K1.1, R1.1, R13.1, TP3.1
/RESET_BUTTON_N: C65.1, R61.2, SW1.1
/RESET_EDGE: C65.2, R63.1
/RESET_PULSE_N: U9.1 (A), U10.4 (Y)
/RESET_PULSE_RC: D65.2 (A), R62.2, R63.2, U10.2 (A)
/SW: D1.1 (A), D1.2 (A), L1.2, Q1.2 (D)
/SWCLK: J4.3, U1.38 (PA14)
/SWDIO: J4.2, U1.37 (PA13)
/VOUT: C1.1, D1.3 (K), J2.1, R10.1, TP1.1
/VOUT_DIV: R10.2, R11.1
/VOUT_SENSE: C10.1, R11.2, R12.1, U1.9 (PA1)
/VRECT_DIV: R13.2, R14.1
/VRECT_SENSE: C11.1, R14.2, R15.1, U1.10 (PA2)

Notes on the sheet:
40 W CCM BOOST PFC | WIRED MODULAR LEARNING SCHEMATIC
Read the energy flow first (01 -> 02), then driver (03), sensing (04-06), fault logic (07), and MCU (08).
Same RevB circuit. Internal functional paths use wires. Matching port labels connect between modules; crossing wires have no implicit connection.
01 AC INPUT / RECTIFIER / PRECHARGE
J1 -> BR1 -> R1; K1 bypasses R1 after precharge
02 BOOST POWER STAGE
L1 -> SW -> D1 -> C1 / J2; Q1 and R2 complete the return
03 MOSFET GATE DRIVER
PWM_CMD -> R30 -> U2 -> R31 -> GATE_Q1
04 KELVIN CURRENT SENSE
R2 sense terminals -> R20 / R21 -> U3 -> ISENSE_ADC
05 VOLTAGE SENSE
Two separate resistor dividers: VOUT and RECT_RAW
06 HARDWARE OVERCURRENT
U4 compares ISENSE_ADC with OCP_REF
09 AUXILIARY POWER
J3 12 V auxiliary input -> U5 -> +3V3
07 FAULT LATCH / POR / MANUAL RESET
OC_RAW -> latch + fast OR -> DRIVER_DISABLE; no MCU clear
08 STM32 CONTROL / SWD / DECOUPLING
Digital control interface; all existing supply and NC connections retained
10 GROUND STAR / TEST POINTS
NT1 is the intended PGND / AGND connection; TP1-TP7 observe nets
K1 coil path is wired to Q2 and D41; its contact path bypasses R1.
R2 pins 1/2: power return. Pins 3/4: independent Kelvin outputs to Module 04.
IN- receives DRIVER_DISABLE. R33 is the existing hardware PWM pulldown.
C20 is between INA_P and INA_N, not an input-to-ground capacitor.
VOUT -> R10/R11/R12
RECT_RAW -> R13/R14/R15
OC_RAW is an independent hardware shutdown input to Module 07.
Manual reset edge -> RC/clamp -> Schmitt U10 -> OR U9 -> latch CLR.
4.7 uF bulk
VDD24 / VSS23
VDD36 / VSS35
VDD48 / VSS47
VDDA21 / VSSA19
VREF+20 / VSSA19
VBAT1 / AGND
The existing circuit directly shares +3V3 and AGND for these pins; no new filter has been added.
MCU calculates digital PI / current reference / PWM. Fault status is read-only.

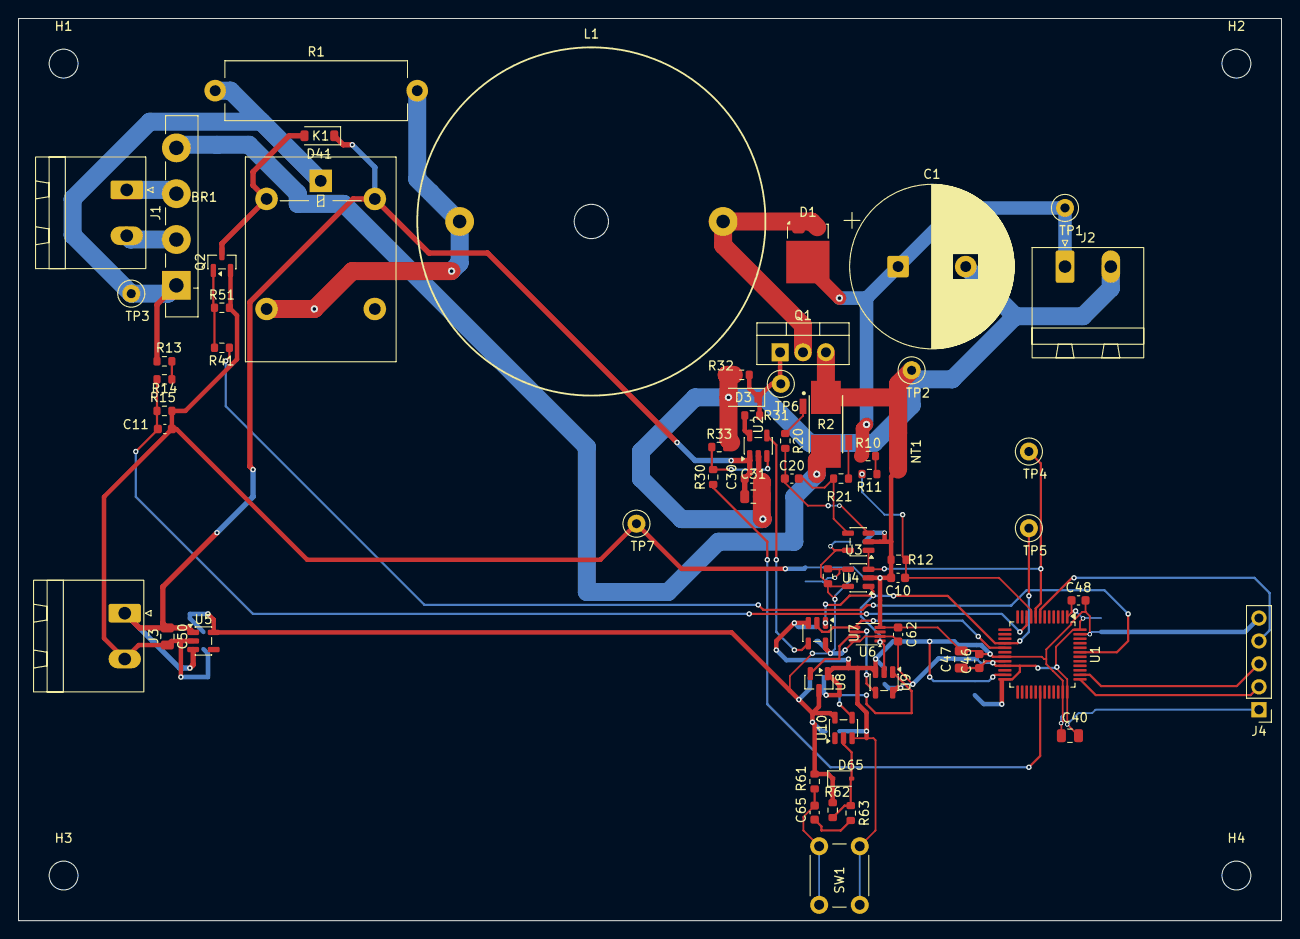
[picture p77: board BoostPFC_40W_RevB.kicad_pcb from above]

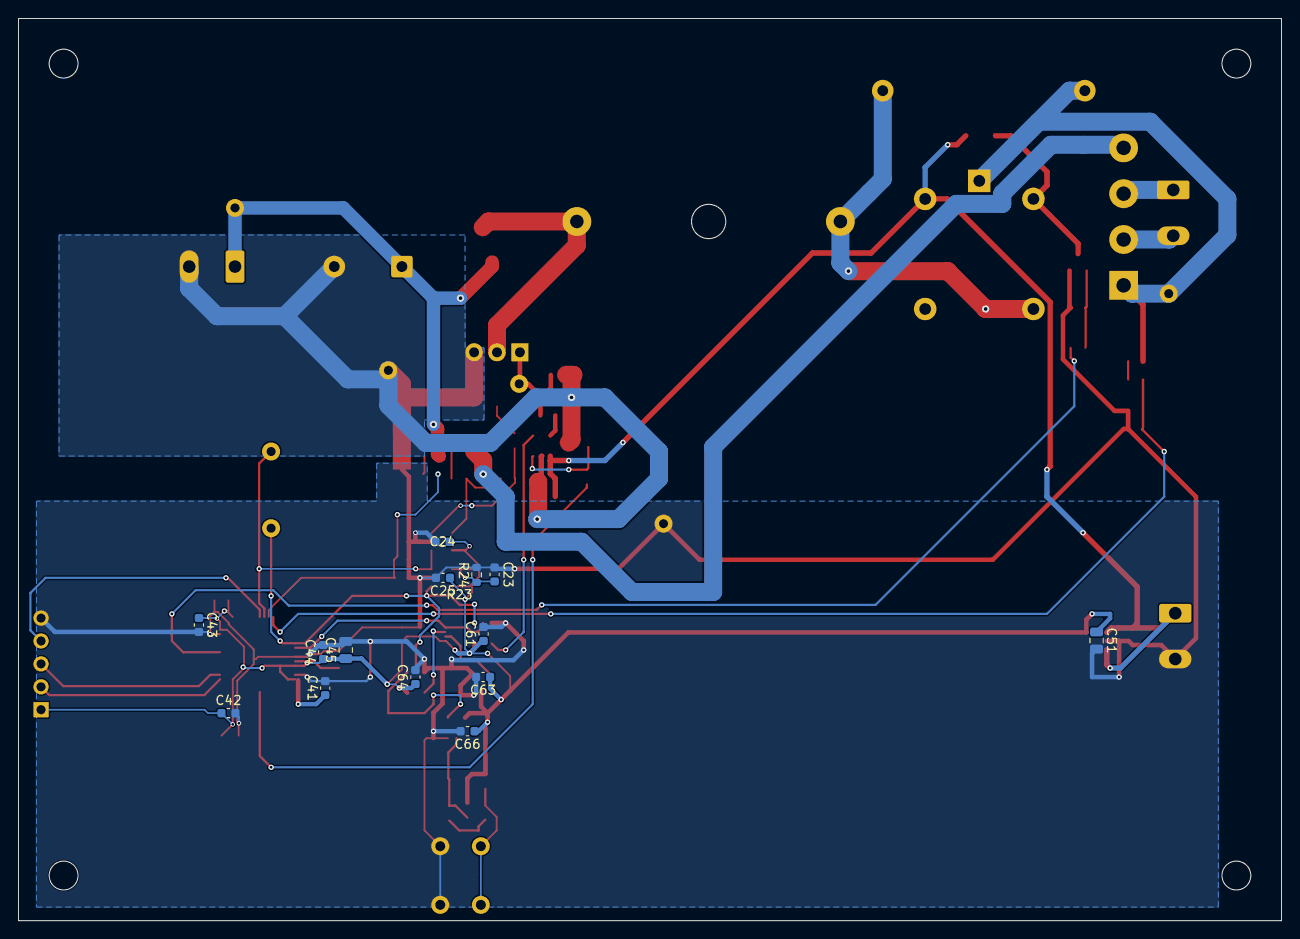
[picture p78: board BoostPFC_40W_RevB.kicad_pcb from below]

Board: 2 copper layers, 140.0 x 100.0 mm, 83 parts (14 on the bottom side), 40 nets.

Other parts of the board:
H1, H2, H3, H4: M3 mounting hole; MountingHole_3.2mm_M3
