lunhuisheng/40W-CCM-Boost-PFC/(commit log)

2026-10-28 Publish 40W Boost PFC design portfolio (RevB WIP)
    [BoostPFC_40W_RevB_ManualLayout.kicad_pcb, BoostPFC_40W_RevB_ManualLayout.kicad_sch]
2026-10-29 Add wired modular schematic and Chinese learning booklet
    [BoostPFC_40W_WiredLearning.kicad_sch]
2026-10-29 Make hand-routed RevB with readable schematic the latest project
    [BoostPFC_40W_RevB.kicad_pcb, BoostPFC_40W_RevB.kicad_sch]
